nxtkim-1/hand-dynamometer/README.md

# hand-dynamometer

A low-cost, 3D-printed grip strength dynamometer built around a load cell, an HX711 amplifier, and an Arduino, together with a Python application that administers a standardized grip test, analyzes the full force-time curve, and compares the result with published normative data.

> **Educational project.** This device is not a medical device and is not intended for diagnosis or clinical decision-making.

<p align="center">
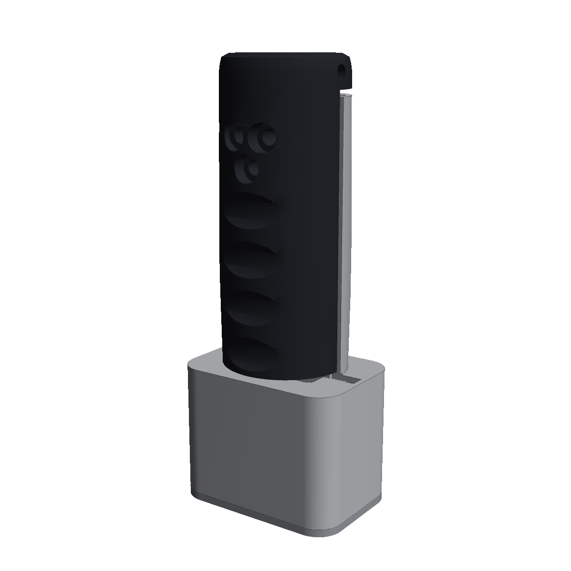
[picture p1: images/compact_v3_assembled.png]
3D-printed grip dynamometer (CAD render)
  
</p>

---

## Hardware

A handheld grip-strength instrument built around a **CZL601 100 kg load cell**. Its barrel-shaped handle splits into two halves; an **HX711** amplifier and **Arduino Nano** read the load cell and send the data to a laptop. Calibration uses known masses through the same load path as a real squeeze.

**Current version: v3** — The split-grip barrel handle has a **flat chamfered top** and sits on a **closed 57 × 82 mm electronics box** (~204 mm tall) for the Nano, HX711 and coiled, uncut cable. All four v3 parts are **native, from-scratch parametric models** in Onshape — **[Hand Dynamometer v3](https://cad.onshape.com/documents/14d87426a9f5f0f89acb0ff1/w/cbee608c747a369f00bd9d19/e/3240b9b82e6414542f1a770b)** (private). The palm half, finger half, bay cover and base test were rebuilt feature by feature (sketches, revolves, extrudes and bolt pattern) from `cad/dynamometer_cad.py` and the v3 mesh measurements. The Jamar-style two-handle concept, a possible **v4 prototype** (`docs/13_jamar_concept.md`, `cad/jamar_concept.py`), is modeled in the same document as a separate part studio with a frame, palm bar, finger part and cover. The renders below show v2 (dome top, round flared base); v3 renders are still pending. Superseded v2 CAD files remain in `cad/archive/superseded_2026-10-16/`.

**CAD status:** All five Onshape part studios regenerate cleanly as native parametric models; known open items are tracked in [docs/14_cad_open_items.md](docs/14_cad_open_items.md).

The grip splits lengthwise. The **grey palm half** bolts to the bottom of the load cell, and the **black finger half** bolts to its top. A 3 mm seam keeps the halves apart, so every squeeze has to pass through the load cell.

A full explanation of the features and design process is in **[`docs/12_design.md`](docs/12_design.md)**.

## Screenshots

Onshape proof captures for the v3 parts and Jamar concept:

- [Palm half](docs/proofs/palm-half.png)
- [Finger half](docs/proofs/finger.png)
- [Bay cover](docs/proofs/cover.png)
- [Base test](docs/proofs/base.png)
- [Jamar v4 concept](docs/proofs/jamar.png)

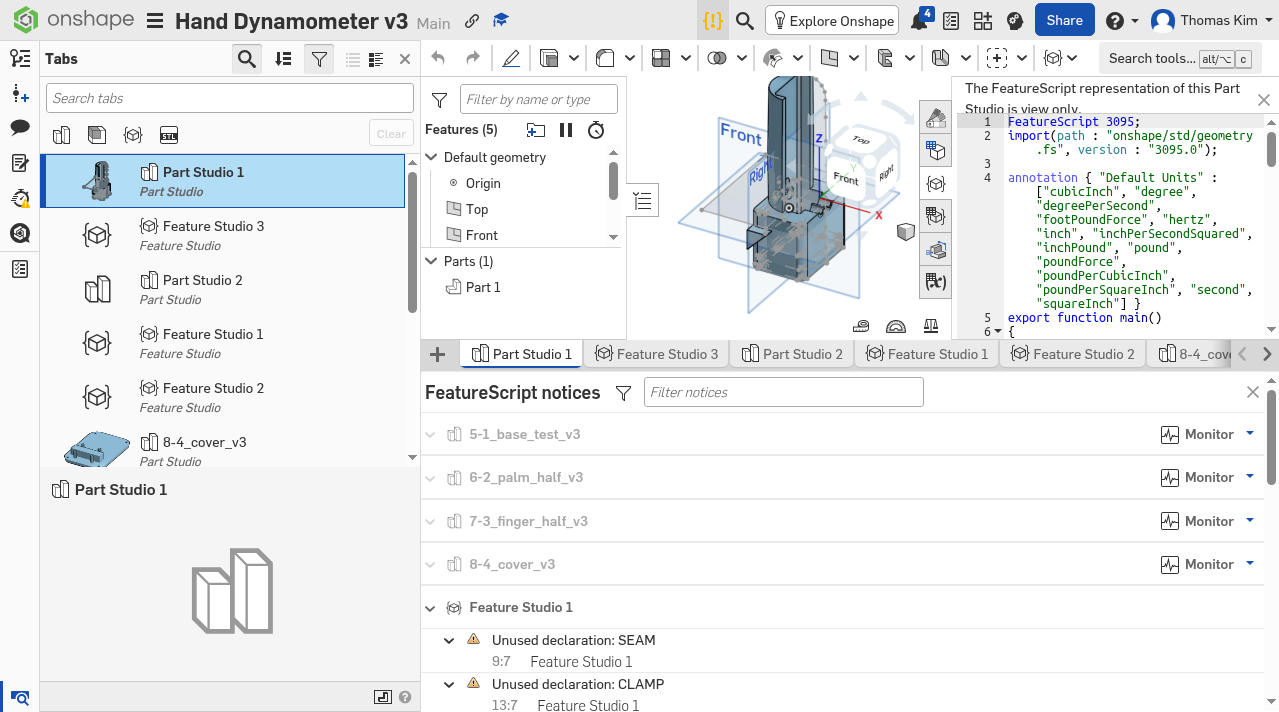
[picture p2: docs/proofs/palm-half.png]
Onshape proof screenshot: v3 palm half


---

## Motivation

Grip strength is one of the simplest and most widely used indicators of overall muscle function. It is associated with mobility, recovery after surgery, and all-cause mortality, and it is a core criterion in current definitions of sarcopenia. Clinical dynamometers such as the Jamar, however, report only a single peak value and cost several hundred dollars.

This project was undertaken to examine whether an inexpensive device could reproduce that peak measurement while also recording the entire force-time curve. Access to the full curve allows metrics that a mechanical dial cannot provide, including the rate at which force develops and the extent to which it declines during sustained effort.

Grip strength is a validated clinical measure and a diagnostic criterion for sarcopenia (EWGSOP2: < 27 kg for men, < 16 kg for women). In the PURE study of about 140,000 people, it predicted mortality better than systolic blood pressure. This device logs the full force–time curve (80 samples per second recommended; see "Run with the Arduino").

---

## Features

- **Web app (GripCheck).** `python webapp.py` opens the test in the browser: a participant form (age, sex, dominant hand, and optional ID, height, weight and injury history), posture instructions, a 3-2-1 countdown, a live force graph, immediate feedback on each trial with the option to repeat it, timed rest periods, and a final report that can be saved as a PDF with the same layout.
- **Standardized protocol.** The application guides the user through three maximal trials per hand, alternating hands to allow recovery, followed by a 30-second sustained-effort fatigue test. Posture instructions and verbal encouragement are fixed in the code so that every trial is administered identically, in keeping with the American Society of Hand Therapists (ASHT) recommendations.
- **Live visualization.** Force is plotted in real time on a scrolling five-second window while each trial is recorded.
- **Five force-time metrics.** Peak force, time to peak force, rate of force development (RFD), fatigue index, and bilateral asymmetry are computed for every session.
- **Normative comparison.** The best grip is compared with age- and sex-specific values from Dodds et al. (2014) and reported as a percentile band, a Z-score, an estimated percentile, and a T-score. The EWGSOP2 and AWGS 2019 cut-offs for low grip strength are applied to users aged 65 and over.
- **Complete data retention.** Every session is saved under a unique timestamp as a raw force-time file, a per-trial summary file, and a centile plot, so that new metrics can later be computed from existing recordings without repeating the test.
- **Hardware-independent development.** A single setting (`USE_FAKE`) switches between the Arduino and a realistic simulated signal, which allows the entire application to be run and tested without the device.
- **Live HTML report.** A browser page opens after the first trial and refreshes as each recording finishes, showing peak force, trial-to-trial coefficient of variation, force-time curves, and the normative comparison.
- **Signal filtering.** Metrics are computed on curves smoothed with a zero-phase, 4th-order Butterworth low-pass filter (10 Hz), while the raw signal is saved unchanged. In a Monte Carlo comparison of 300 simulated trials, this filter reduced the spread of RFD error with little bias, whereas a 5-point moving average introduced a consistent overestimate.
- **Session history.** `history.py` uses pandas to combine every saved session into a dashboard of best peak force, coefficient of variation, and fatigue index over time.
- **Automatic trial-quality check.** Each maximal trial is classified as good, false start, slip, or submaximal effort from five shape features, and the operator is warned immediately so that the trial can be repeated. A Random Forest trained on 2,000 synthetic curves reached 99% test accuracy, compared with 92% for hand-tuned rules. Because the training data are simulated, this result demonstrates the pipeline rather than accuracy on real users.
- **Hardware safeguards.** The app accepts both the simulator's two-column format and the firmware's four-column format, measures the real sample rate of every recording, adapts the filter to it, reports RFD as n/a when sampling is too slow to estimate it, and stops with a clear message if the firmware has not been calibrated.
- **Automated tests.** A pytest suite (34 tests) checks the metrics against curves with known answers, verifies that filtering does not shift the signal in time, and runs the full protocol end to end, in the terminal app and in the web app, with simulated data and with a simulated Arduino that speaks the real firmware format.

### Example output
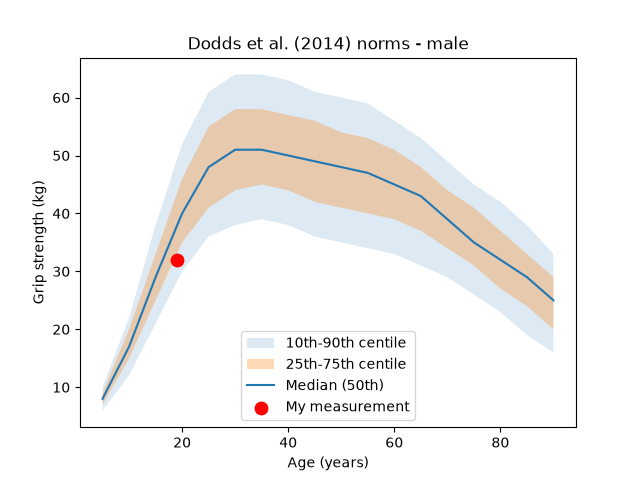
[picture p3: images/centile_plot.png]
Grip strength plotted on Dodds et al. (2014) centile curves


---

## How to run

The top-level Python app runs a standardized grip test on the device, or on fake data while the hardware is being built.

### Requirements
Python 3.9 or later.

```bash
pip install -r requirements.txt
```

### Run the web app (recommended)
```bash
python webapp.py
```
A browser tab opens at **http://localhost:8000**. Follow the instructions on screen; press **Download PDF** on the final report to save it. The newest report is always at http://localhost:8000/report. The app only accepts connections from this computer. (Port 8000 is used because macOS reserves 5000 for AirPlay.)

### Public online demo
The repository includes `render.yaml`, so the web app can be published on [Render](https://render.com) for free:
1. Sign in to Render with GitHub and choose **New → Blueprint**.
2. Select this repository. Render reads `render.yaml`, installs `requirements.txt`, and starts the app with gunicorn.
3. After a few minutes the demo is live at `https://<service-name>.onrender.com`.

The online demo runs with `GRIPCHECK_DEMO=1`: every squeeze is simulated (no device can be connected over the internet), each visitor's test is kept separate, and each report is reachable only through its own private link. On the free plan the server sleeps after about 15 minutes without visitors, so the first page load afterwards can take up to a minute.

### Run in the terminal
```bash
python grip_test.py
```
Enter age, sex, and dominant hand when prompted, then press Enter before each trial. Results are printed to the terminal and saved to the `sessions/` folder.

### Run with the Arduino

No code needs editing. Plug the dynamometer in by USB and close the Arduino IDE's Serial Monitor (only one program can use the port).

**Windows, double-click:** `check_device.bat` runs a one-minute check (hands off, squeeze, let go) and prints PASS/WARN/FAIL with fixes. `start_gripcheck.bat` then opens GripCheck with the device. The first run installs the Python packages into `.venv` (Python 3.12 from python.org must be installed, with "Add python.exe to PATH" ticked).

**From a terminal (any OS):**
```bash
python software/check_device.py      # health check
python webapp.py --device            # web app, port found automatically
python grip_test.py --device         # terminal version
python webapp.py --device --port COM7   # only if several serial devices are plugged in
```

**In the browser (Chrome or Edge):** run `python webapp.py`, or open a deployed GripCheck site, and press **Connect device** on the first screen. The browser reads the device through Web Serial and the server analyses each trial exactly as in the other routes. On a deployed site, nothing has to be installed on the visitor's computer.

**Firmware:** upload `firmware/grip_firmware_tillaart/grip_firmware_tillaart.ino` (Rob Tillaart's HX711 library) or `firmware/grip_firmware/grip_firmware.ino` (Bogdan Necula's). Both print `t_ms,raw,net,force_kg` at 115200 baud and re-zero on `T`.

**Calibration status (2026-11-12): estimated.** `COUNTS_PER_KG = 42952` comes from the load-cell datasheet (about ±10 %), not from known masses. The app and every report say so in a banner. After the known-mass calibration (`docs/04_calibration.md`), paste the fitted value into the firmware and set `CALIBRATION = "measured"` in `grip_test.py` (or `GRIPCHECK_CALIBRATION=measured`); the banner then disappears.

**Sample rate:** the HX711 runs at 10 samples/s until its RATE pin is tied high (80 samples/s). At 10 Hz everything works except rate of force development, which is reported as n/a.

### Run the tests
```bash
python -m pytest
```

### Other scripts
| Command | Purpose |
|---|---|
| `python fake_data.py` | Plots one simulated maximal trial and one simulated fatigue trial |
| `python metrics.py` | Computes all metrics on simulated curves as a quick self-check |
| `python grip_compare.py` | Prints normative reports for four example cases |
| `python filters.py` | Compares raw, moving-average and Butterworth RFD over 300 simulated trials |
| `python history.py` | Builds a dashboard of all saved sessions |
| `python quality.py` | Shows the rule-based quality check on one curve of each fault type |
| `python train_quality.py` | Trains and evaluates the trial-quality classifier |

## Project structure

```
hand-dynamometer/
├── grip_test.py        # Main application: protocol, live plot, saving, summary
├── metrics.py          # Peak force, time to peak, RFD, fatigue index, asymmetry
├── grip_compare.py     # Comparison with Dodds et al. (2014) norms and clinical cut-offs
├── fake_data.py        # Simulated force-time curves (good and faulty trials) for hardware-free testing
├── webapp.py           # Browser version of the test (Flask): same protocol, metrics and report
├── render.yaml         # Settings for the public online demo on Render
├── web/                # Web app pages: index.html, style.css, app.js (live graph, countdown)
├── report.py           # HTML session report (live in the terminal app, final in both; prints to PDF)
├── filters.py          # Moving-average and Butterworth filters, sample-rate estimate
├── history.py          # pandas dashboard of all sessions
├── quality.py          # Rule-based and ML trial-quality check
├── train_quality.py    # Trains the Random Forest classifier
├── models/             # Saved quality model
├── tests/              # pytest suite
├── requirements.txt
├── cad/
│   ├── dynamometer_cad.py   # The whole design, parametric; regenerates every part and checks it
│   ├── render_final.py      # The renders in images/
│   ├── draw_final.py        # The dimensioned drawing
│   ├── output/              # STL + STEP per part, assembly.step
│   ├── output/print_ready/  # STLs ready for Bambu Studio (do not rotate them)
│   └── archive/             # Earlier design iterations
├── firmware/
│   └── grip_firmware/       # Arduino sketch
├── software/           # logger.py, calibrate.py, analyze_hold.py: serial logging and calibration
├── data/               # dodds2014_norms.csv, example calibration points
├── docs/               # Design notes, incl. 12_design.md and 13_jamar_concept.md (v4 concept)
├── images/             # Renders, drawings, and photos
├── practice/           # Earlier development versions, kept for reference
└── sessions/           # Saved test sessions (excluded from version control)
```

### Data format
The simulator sends one line per sample at 50 samples per second; the firmware sends four columns:
```
timestamp_ms,force_kg               (simulator)
timestamp_ms,raw,net,force_kg       (firmware)
```
The app reads the first column as time and the last column as force, so both formats work without changes. Lines that are not data, such as `# tared`, are skipped.

---

## Metric definitions

| Metric | Definition |
|---|---|
| **Onset** | The first sample at which force exceeds 5% of the trial's peak. A relative threshold is used so that sensor noise is not mistaken for the start of a squeeze. |
| **Peak force (kg)** | The highest force recorded during the trial. The best of three trials per hand is reported, consistent with the method used to construct the normative data. |
| **Time to peak (ms)** | The time from onset to peak force. |
| **Rate of force development (N/s)** | The slope of a least-squares line fitted to force (converted to newtons, 1 kg = 9.81 N) over the first 200 ms after onset. Fitting a line to all points in the window, rather than using only the first and last points, reduces the influence of individual noisy samples. |
| **Fatigue index (%)** | (Peak force − mean force during the final second of the 30 s effort) ÷ peak force × 100. The final second is averaged rather than taken as a single point to reduce the effect of noise. |
| **Bilateral asymmetry** | The ratio of left-hand to right-hand peak force, together with the percentage by which the weaker hand is weaker. The commonly cited "10% rule" for the dominant hand is not applied, because the literature does not support it consistently; the values are reported without a verdict. |

---

## Normative data

Normative grip strength values are transcribed from Table 2 of:

Dodds RM, Syddall HE, Cooper R, et al. (2014). Grip Strength across the Life Course: Normative Data from Twelve British Studies. *PLoS ONE* 9(12): e113637. https://doi.org/10.1371/journal.pone.0113637 (CC BY 4.0)

The measurement is matched to the row with the closest age and the same sex. The Z-score uses that row's mean and standard deviation, and the T-score uses the young-adult peak (age 32) from the same study.

### Why 27 kg and 16 kg?
The EWGSOP2 cut-offs for low grip strength (men < 27 kg, women < 16 kg) correspond to a T-score of −2.5 relative to the young-adult peak reported by Dodds et al. (2014):
- Men: 51.9 − 2.5 × 9.9 = 27.15 kg
- Women: 31.4 − 2.5 × 6.1 = 16.15 kg

Both EWGSOP2 (Cruz-Jentoft et al., 2019) and AWGS 2019 (Chen et al., 2020) define these cut-offs for older adults, so they are reported only for users aged 65 and over.

---

## Validation (in progress)

The software has been developed and tested using simulated signals. Validation of the physical device is planned in two stages:

1. **Calibration.** Known masses will be applied across the measurement range (at least five points), and linearity will be reported as maximum deviation as a percentage of full scale rather than R², since R² is close to 1 for almost any load cell and therefore says little about accuracy.
2. **Agreement with a clinical device.** Paired measurements will be taken with this device and a Jamar hydraulic dynamometer under the same ASHT protocol, and agreement will be assessed with Bland-Altman analysis (bias and 95% limits of agreement). Correlation alone is not used, because two devices can be perfectly correlated while still disagreeing by a constant amount.

Results will be added to this section once the hardware is complete.

---

## Limitations

- All results shown in this repository were produced with **simulated data**. They demonstrate that the analysis pipeline works, not that the device is accurate.
- The normative data come from British cohorts and may not represent other populations.
- The comparison uses the nearest age band rather than interpolating between bands.
- The trial-quality model was trained only on simulated curves sampled at 50 Hz; it has not yet been tested on real fault trials.
- The estimated percentile assumes that grip strength is normally distributed within each age band, which is an approximation.
- Any future validation will involve a small number of participants (the authors), so it will indicate feasibility rather than establish clinical accuracy.

---

## Authors

- **Thomas Kim** — hardware design, mechanical assembly, and Arduino firmware
- **Samuel Koo** — Python application, signal analysis, and normative comparison

## License

Software is released under the MIT License. Hardware design files, documentation, and images are released under CC BY 4.0. See [LICENSE](LICENSE) for details.
