nxtkim-1/hand-dynamometer/docs/14_cad_open_items.md

# CAD open items

These details are tracked rather than treated as resolved. Check them during assembly and physical verification.

- The bay-cover pedestal overlaps the palm's bay slab by about 2 mm in the models. Both parts follow their own meshes; check the fit at assembly.
- The finger-half model follows the v2 parametric length, while the v3 finger mesh is about 19 mm shorter. Groove and hook placement on the physical v3 finger is unverified.
- The base-test model approximates the pocket-to-shelf ramp with the palm's boss/ledge/gusset profile.
