nxtkim-1/hand-dynamometer/docs/proofs/base.png

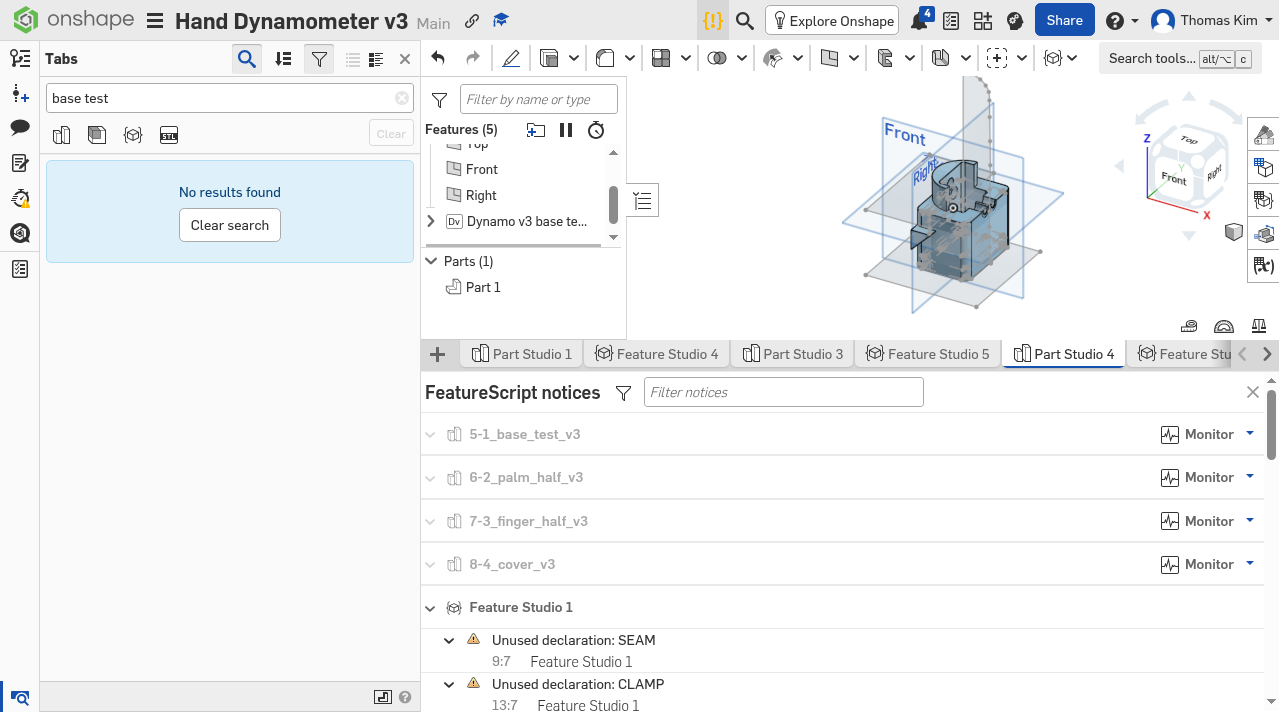
docs/proofs/base.png
