nxtkim-1/hand-dynamometer/docs/proofs/cover.png

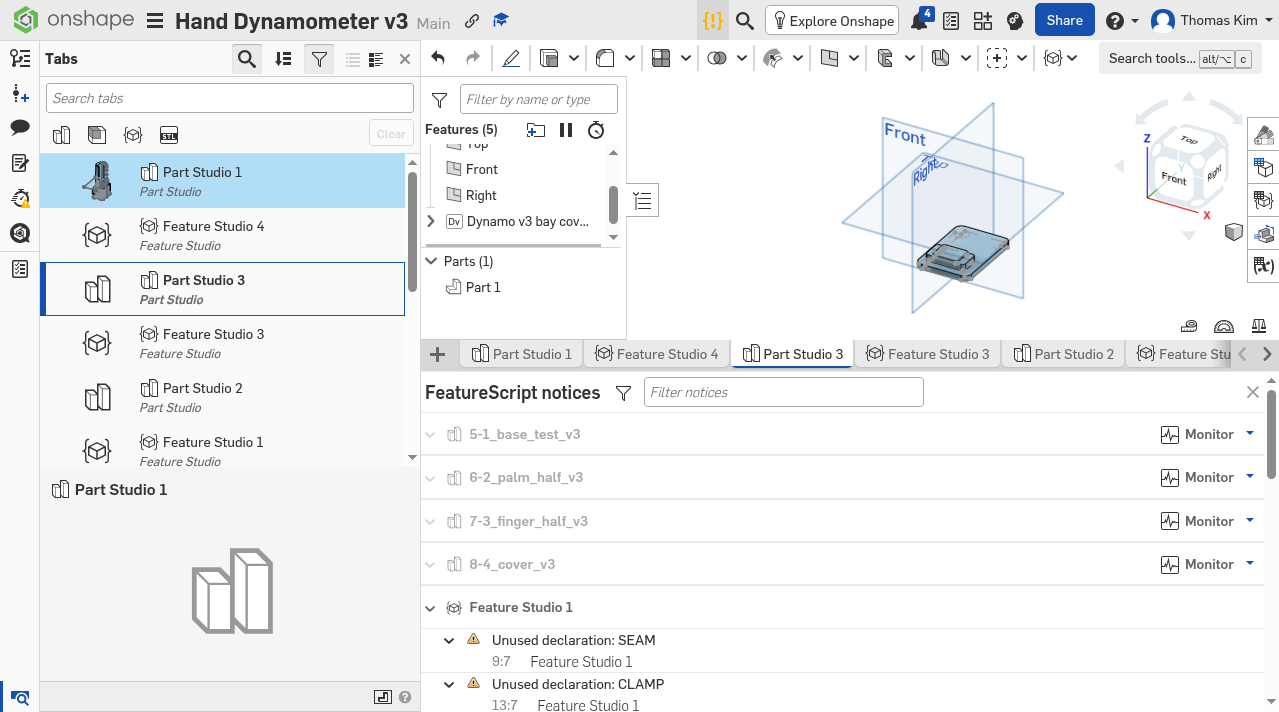
docs/proofs/cover.png
