nxtkim-1/hand-dynamometer/docs/proofs/finger.png

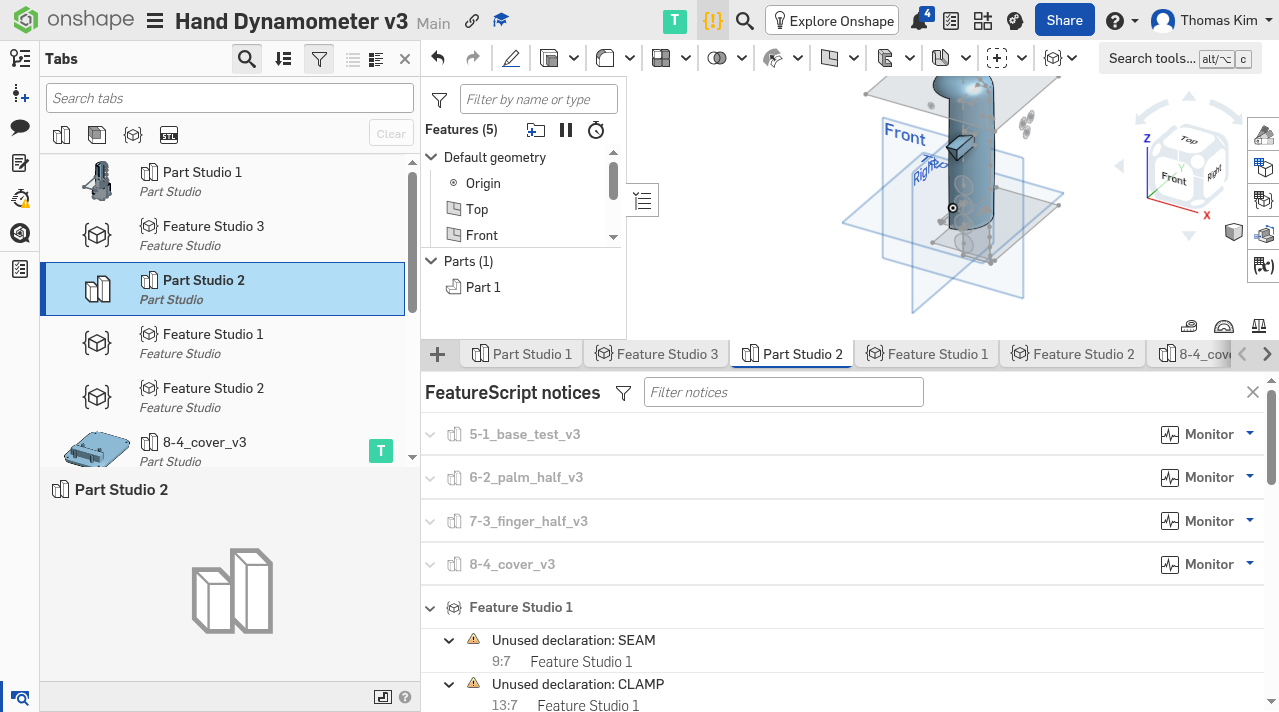
docs/proofs/finger.png
