nxtkim-1/hand-dynamometer/images/compact_v3_cable_bay.png

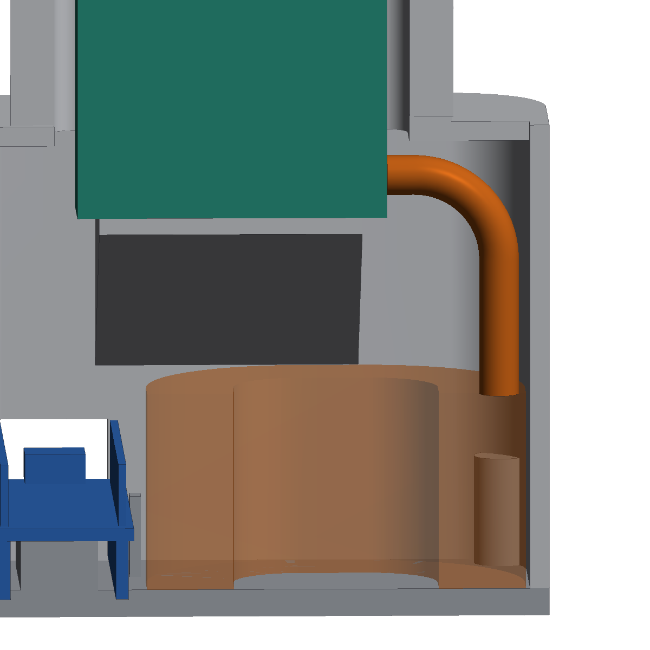
images/compact_v3_cable_bay.png
