nxtkim-1/hand-dynamometer/images/compact_v3_inside.png

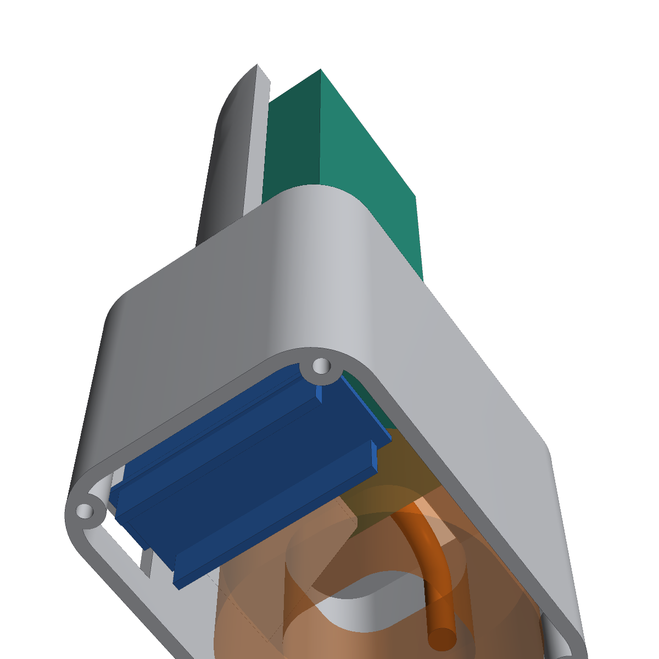
images/compact_v3_inside.png
