nxtkim-1/hand-dynamometer/images/dish_draft_section.png

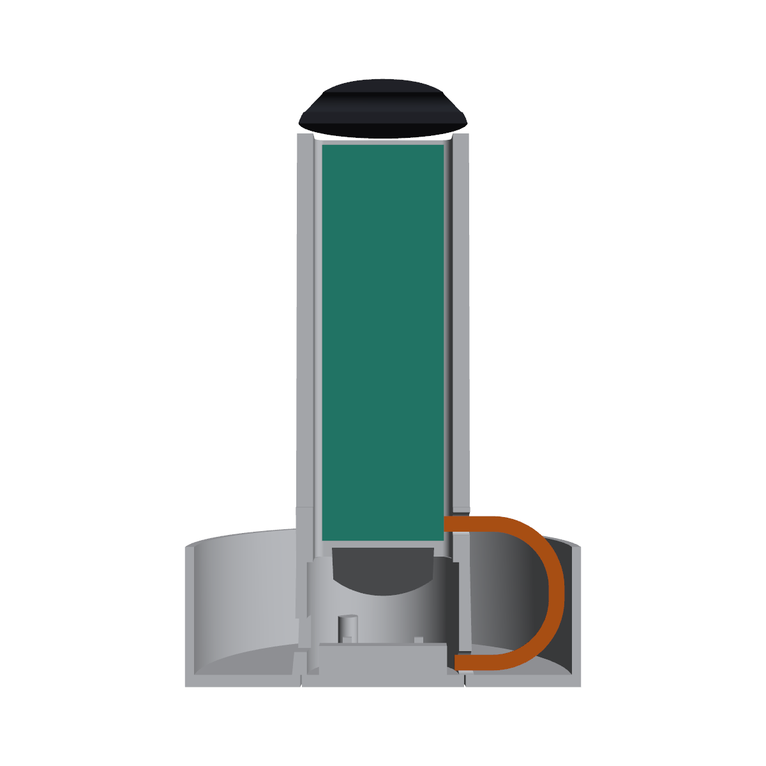
images/dish_draft_section.png
