nxtkim-1/hand-dynamometer/images/filter_comparison.png

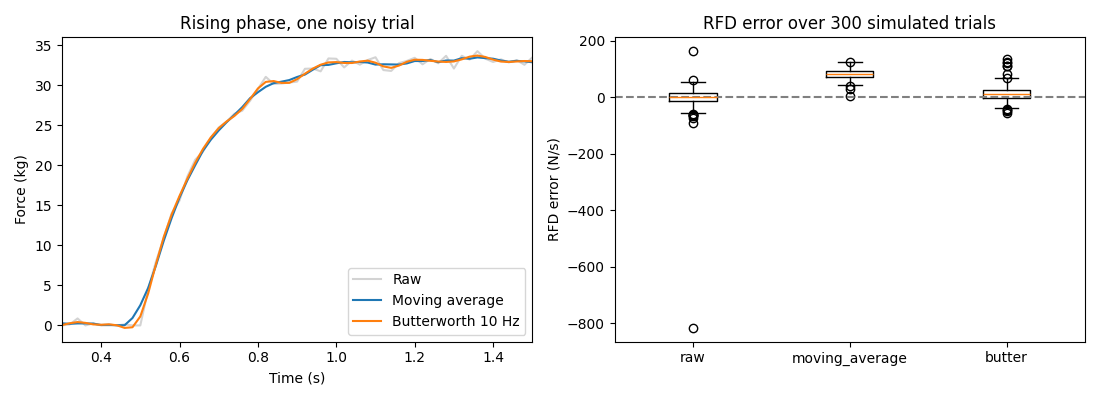
images/filter_comparison.png
