nxtkim-1/hand-dynamometer/images/final_drawing.png

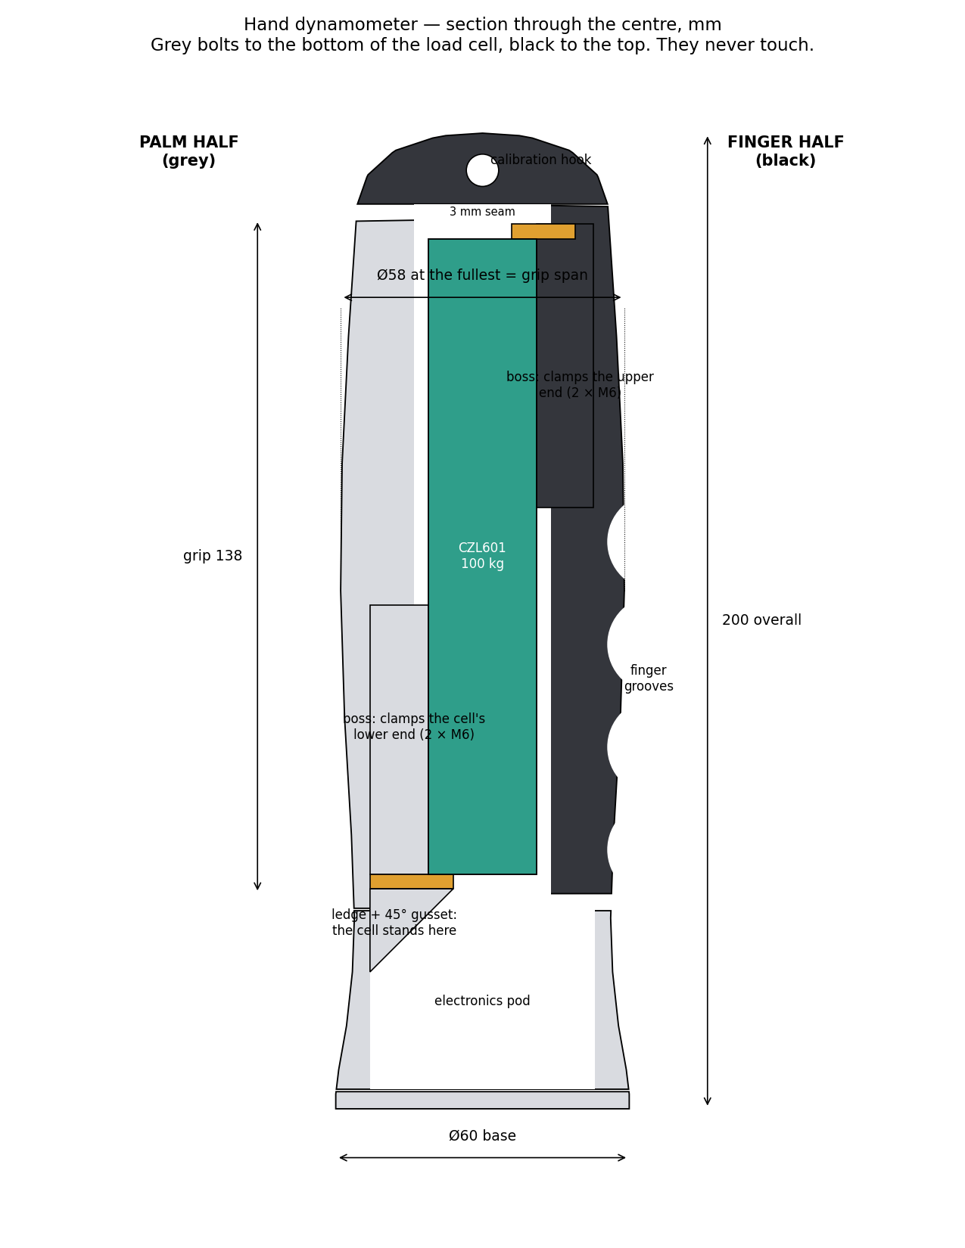
images/final_drawing.png
