nxtkim-1/hand-dynamometer/images/jamar_concept_section.png

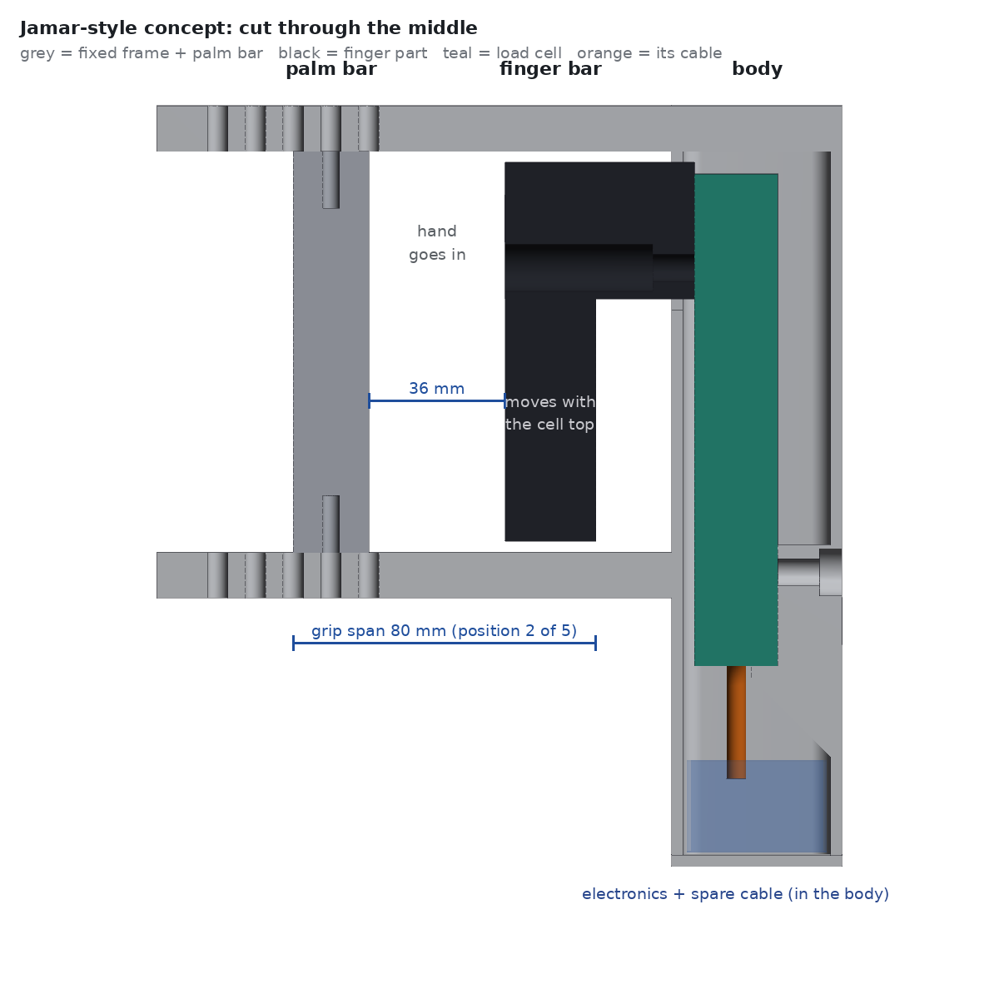
images/jamar_concept_section.png
