nxtkim-1/hand-dynamometer/images/jamar_concept_view.png

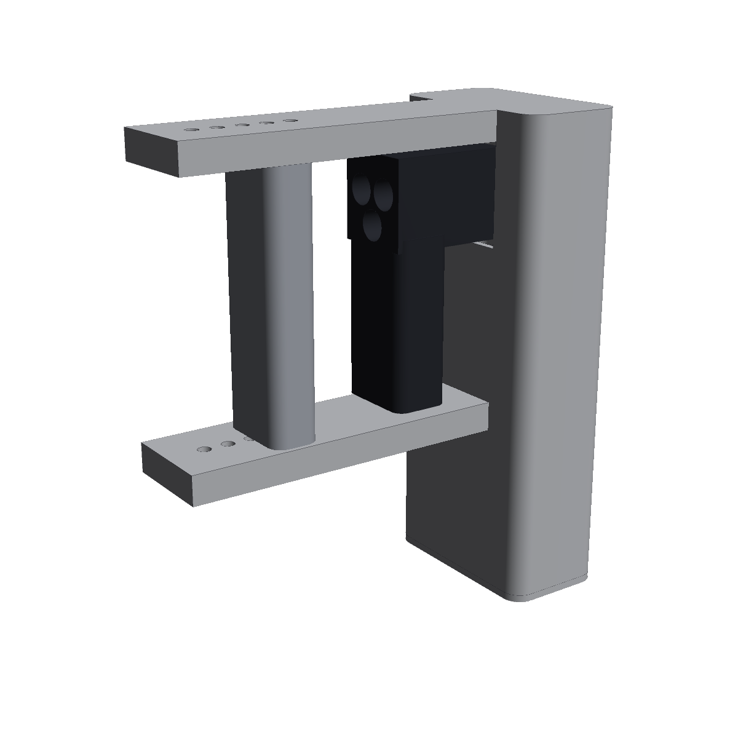
images/jamar_concept_view.png
