nxtkim-1/hand-dynamometer/images/options_compact_vs_dish.png

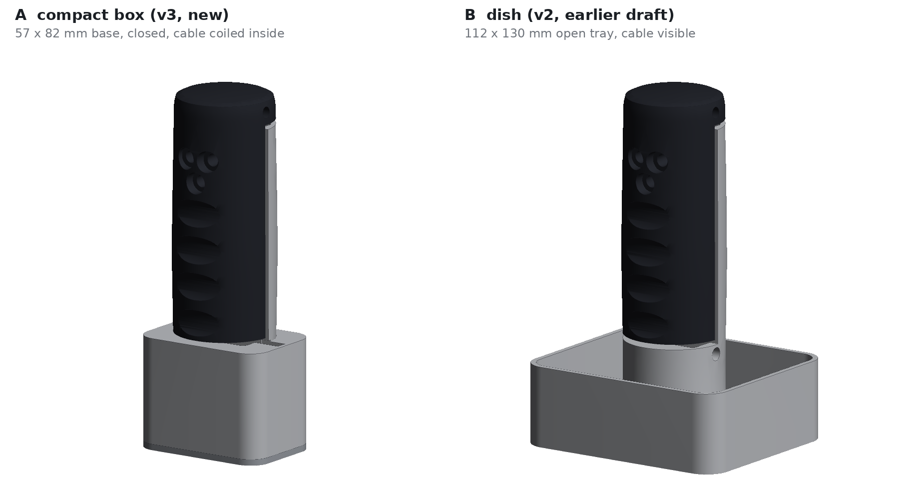
images/options_compact_vs_dish.png
