nxtkim-1/hand-dynamometer/images/photos/2026-10-12_cell_side.jpg

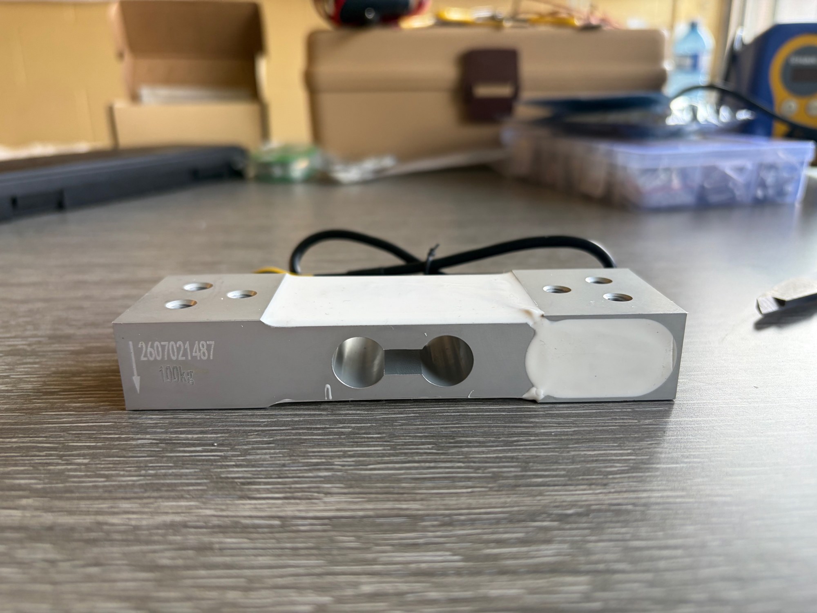
images/photos/2026-10-12_cell_side.jpg
