nxtkim-1/hand-dynamometer/images/photos/2026-10-12_cell_top.jpg

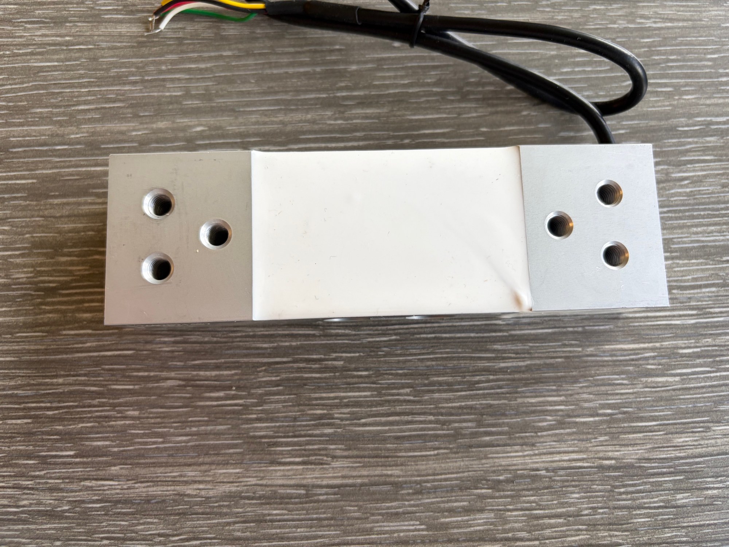
images/photos/2026-10-12_cell_top.jpg
