nxtkim-1/hand-dynamometer/images/photos/reference_hx711.png

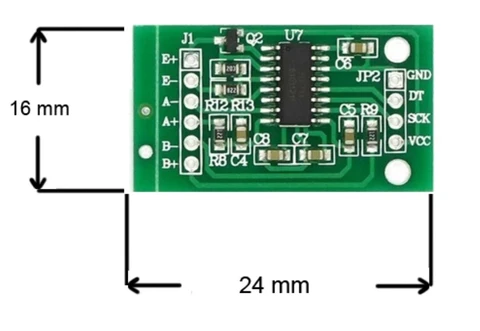
images/photos/reference_hx711.png
