nxtkim-1/hand-dynamometer/images/photos/reference_nano_3d.png

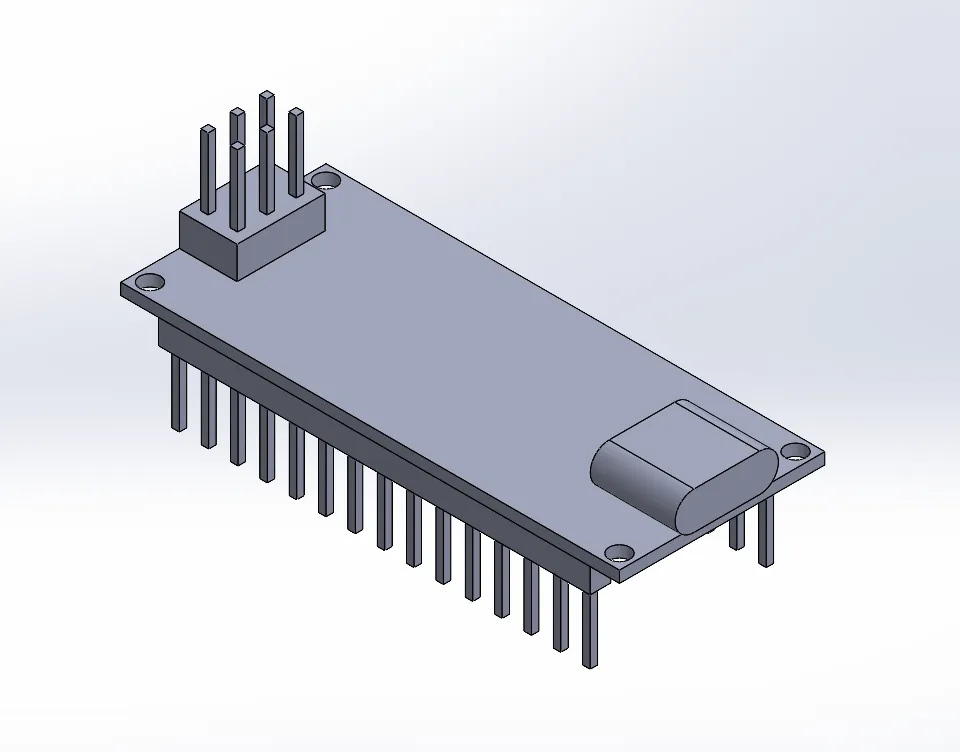
images/photos/reference_nano_3d.png
