nxtkim-1/hand-dynamometer/images/photos/reference_nano_drawing.png

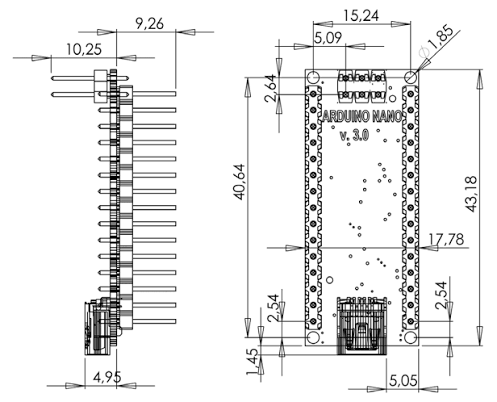
images/photos/reference_nano_drawing.png
