nxtkim-1/hand-dynamometer/images/pod_layout.png

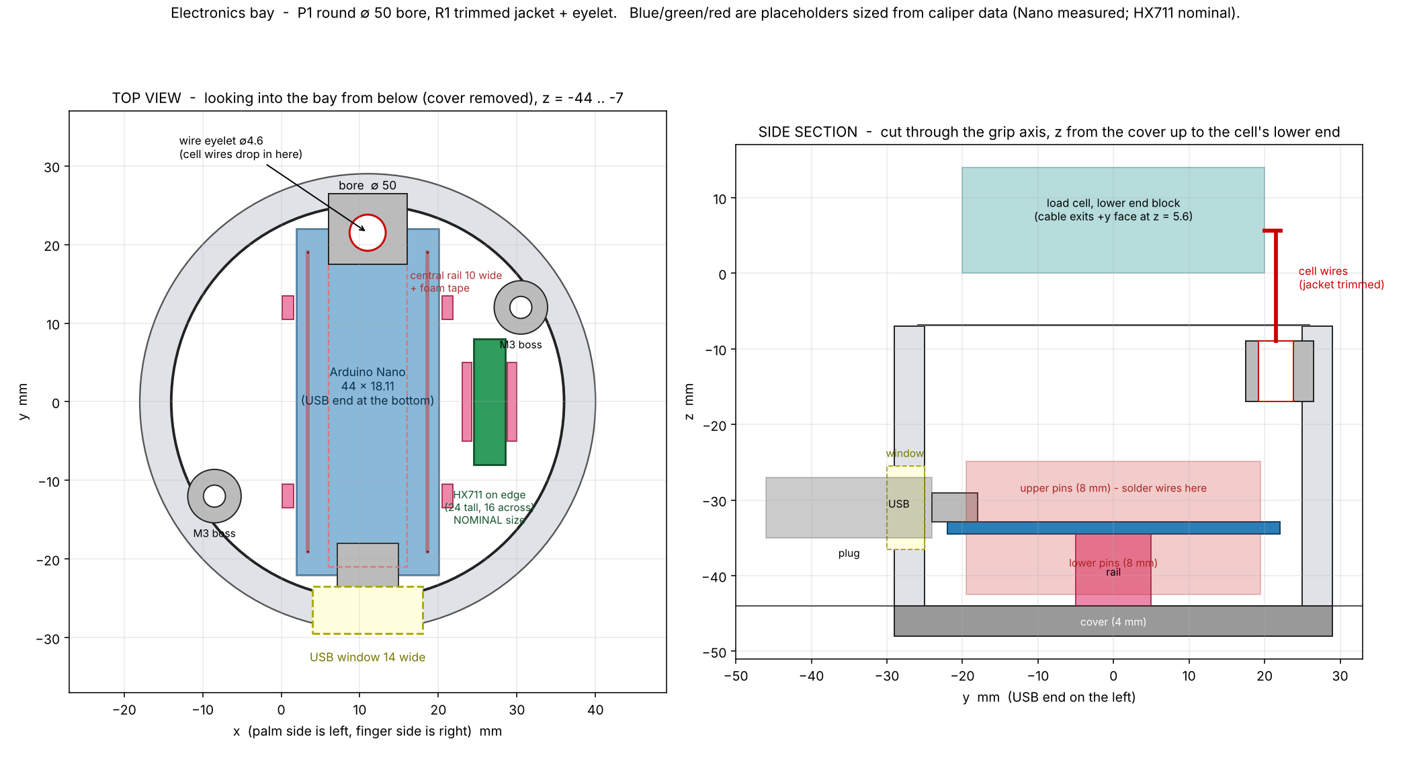
images/pod_layout.png
