nxtkim-1/hand-dynamometer/images/quality_model.png

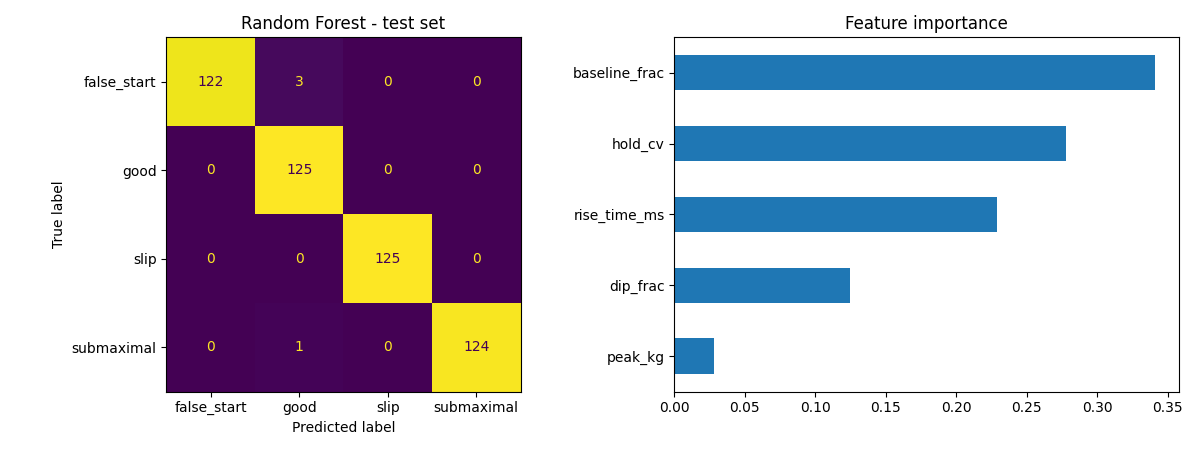
images/quality_model.png
