nxtkim-1/hand-dynamometer/cad/output/concept_jamar/cover_CONCEPT.step

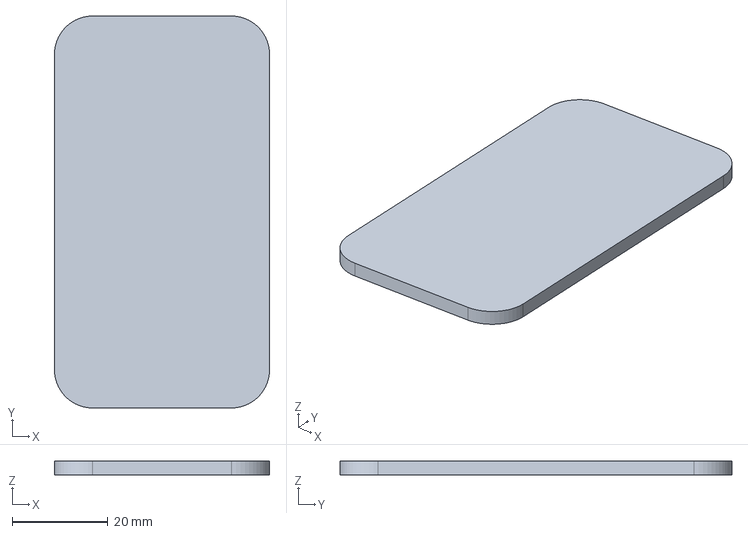
[picture p23: CAD file, 2026-10-20]
cad/output/concept_jamar/cover_CONCEPT.step
45.0 x 82.0 x 3.00 mm
