nxtkim-1/hand-dynamometer/cad/output/print_ready/3_finger_half_v3.stl

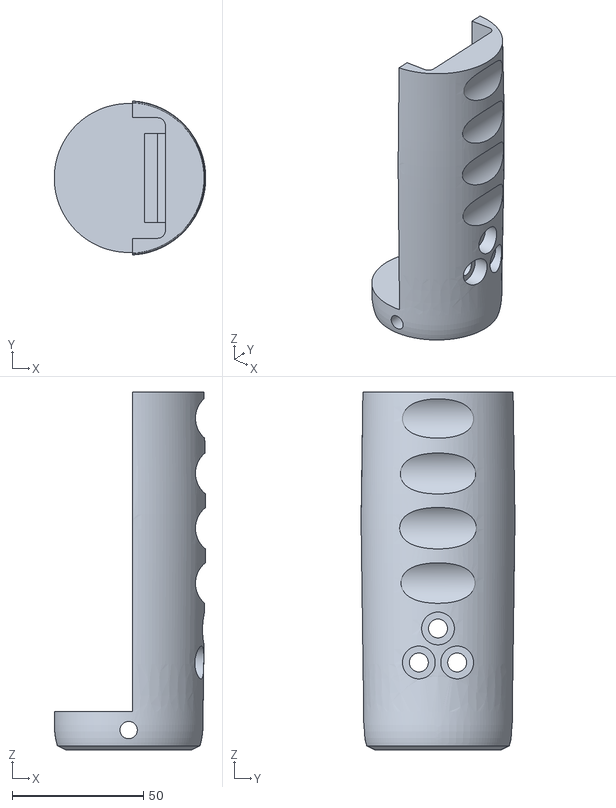
[picture p24: CAD file, 2026-10-20]
cad/output/print_ready/3_finger_half_v3.stl
57.8 x 58.7 x 136.6
