nxtkim-1/hand-dynamometer/cad/output/v3/coil_zone_v3.stl

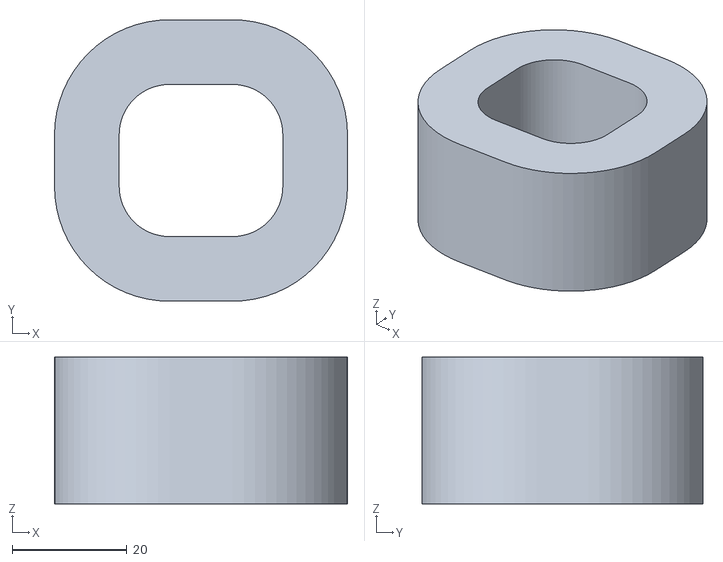
[picture p25: CAD file, 2026-10-20]
cad/output/v3/coil_zone_v3.stl
51.0 x 49.0 x 25.5
