nxtkim-1/hand-dynamometer/cad/output/concept_jamar/finger_part_CONCEPT.step

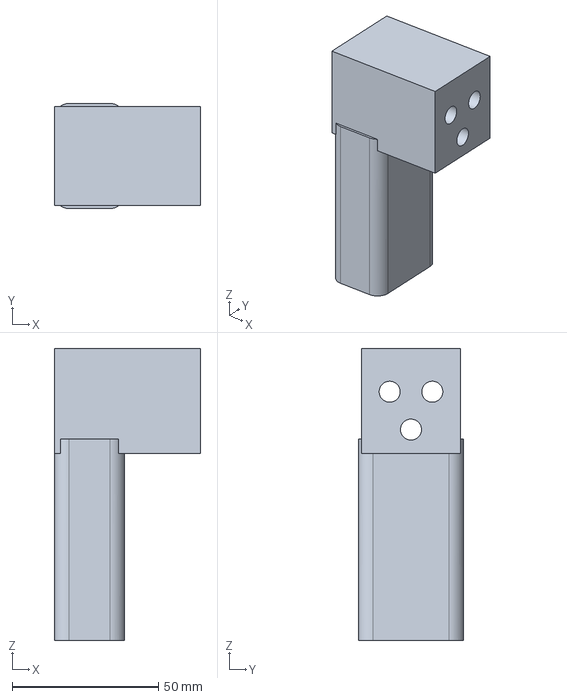
[picture p26: CAD file, 2026-10-20]
cad/output/concept_jamar/finger_part_CONCEPT.step
50.0 x 36.0 x 100.0 mm
