nxtkim-1/hand-dynamometer/cad/output/print_ready/fit_coupon_v2_print.stl

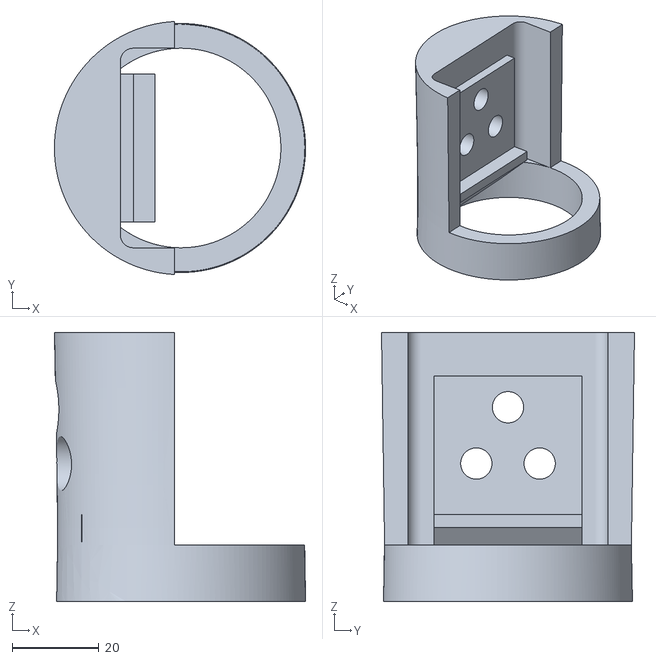
[picture p27: CAD file, 2026-10-20]
cad/output/print_ready/fit_coupon_v2_print.stl
57.9 x 58.3 x 62.0
