nxtkim-1/hand-dynamometer/cad/output/v3/base_test_v3.step

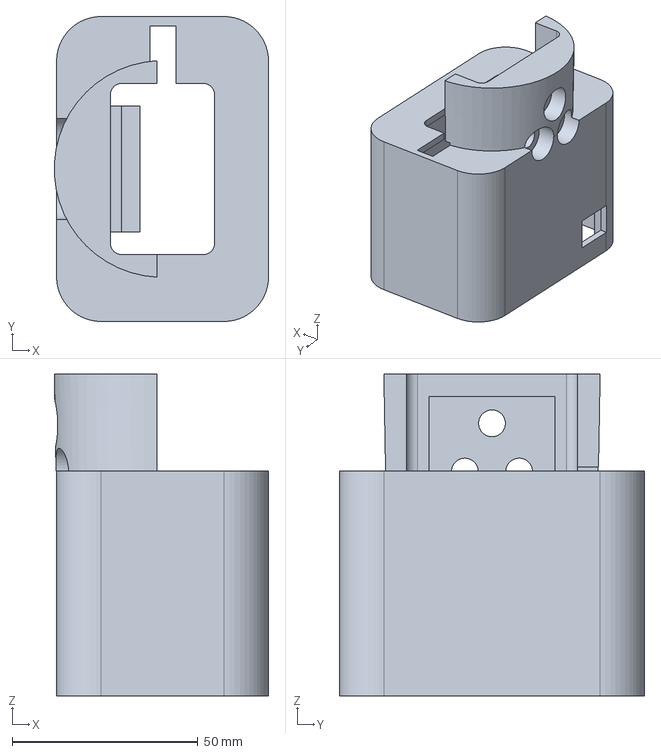
[picture p28: CAD file, 2026-10-20]
cad/output/v3/base_test_v3.step
57.6 x 82.0 x 86.5 mm
