nxtkim-1/hand-dynamometer/cad/output/concept_jamar/frame_CONCEPT.step

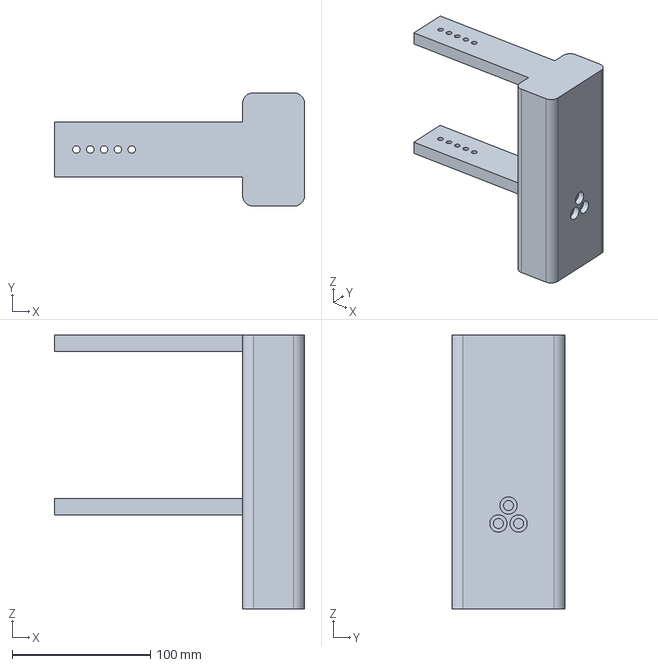
[picture p29: CAD file, 2026-10-20]
cad/output/concept_jamar/frame_CONCEPT.step
181.0 x 82.0 x 198.0 mm
