nxtkim-1/hand-dynamometer/cad/output/print_ready/4_cover_v3.stl

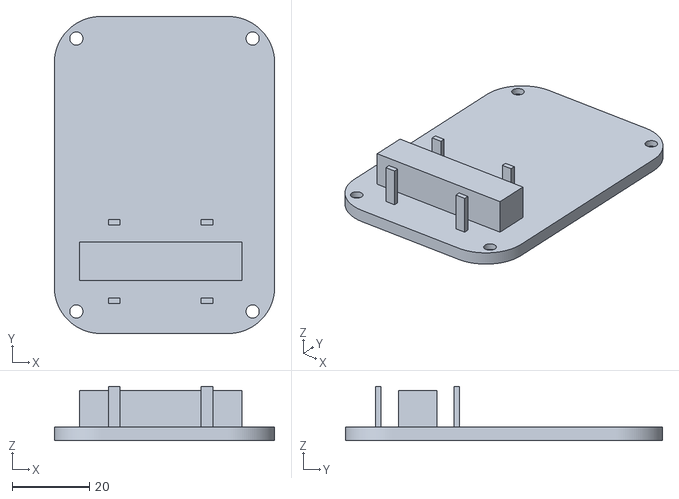
[picture p30: CAD file, 2026-10-20]
cad/output/print_ready/4_cover_v3.stl
57.0 x 82.0 x 14.0
