nxtkim-1/hand-dynamometer/cad/output/concept_jamar/palm_bar_CONCEPT.step

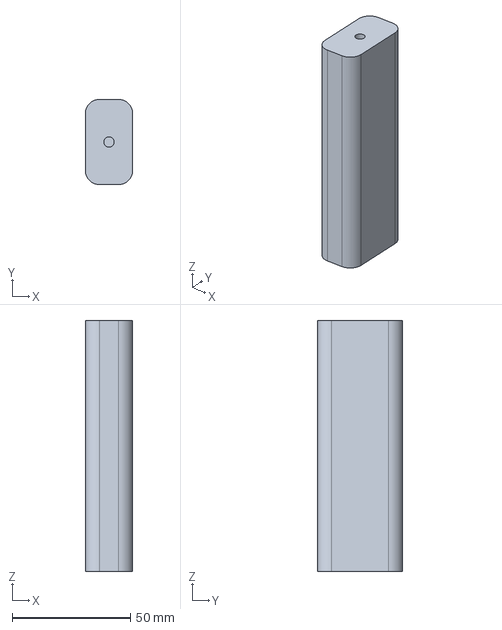
[picture p31: CAD file, 2026-10-20]
cad/output/concept_jamar/palm_bar_CONCEPT.step
20.0 x 36.0 x 106.0 mm
