nxtkim-1/hand-dynamometer/cad/output/print_ready/2_palm_half_v3.stl

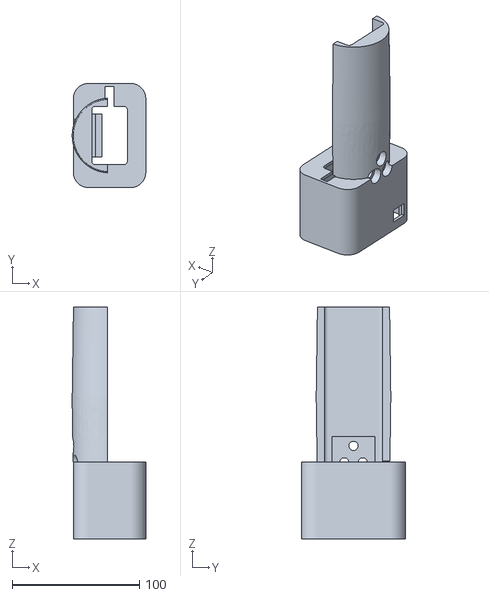
[picture p32: CAD file, 2026-10-20]
cad/output/print_ready/2_palm_half_v3.stl
57.9 x 82.0 x 182.5
