nxtkim-1/hand-dynamometer/cad/output/v3/cable_path_v3.stl

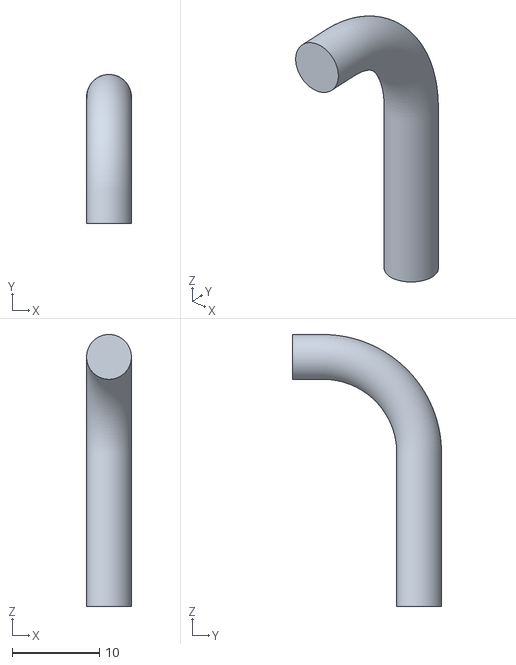
[picture p33: CAD file, 2026-10-20]
cad/output/v3/cable_path_v3.stl
5.13 x 17.1 x 31.1
