nxtkim-1/hand-dynamometer/cad/archive/v1_30mm_cell/output_v1/assembly.step

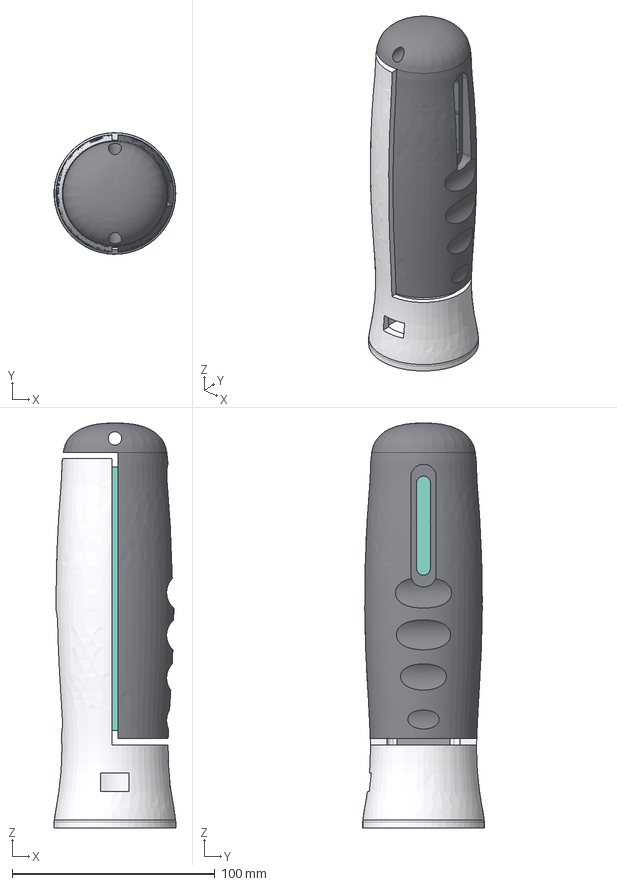
[picture p34: CAD file, 2026-10-20, an earlier design]
cad/archive/v1_30mm_cell/output_v1/assembly.step
59.9 x 60.0 x 199.6 mm
palm_half
finger_half
cover
load_cell
