nxtkim-1/hand-dynamometer/cad/archive/superseded_2026-10-16/round_pod_outputs/assembly.step

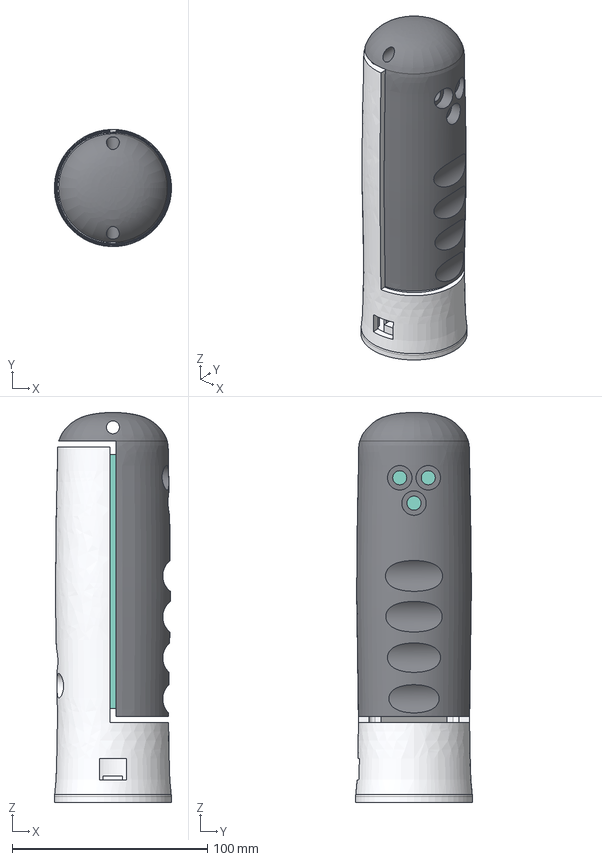
[picture p35: CAD file, 2026-10-20, an earlier design]
cad/archive/superseded_2026-10-16/round_pod_outputs/assembly.step
59.9 x 60.0 x 199.6 mm
palm_half
finger_half
cover
load_cell
