nxtkim-1/hand-dynamometer/(list of files, cad)

Other CAD files:
cad/output/v3/finger_compact_v3.step
cad/output/v3/cover_compact_v3.step
cad/output/print_ready/1_base_test_v3.stl
cad/output/v3/palm_compact_v3.step
cad/archive/superseded_2026-10-16/draft_compact/base_test_v3_DRAFT.step
cad/archive/superseded_2026-10-16/draft_compact/base_test_v3_DRAFT_do_not_print.stl
cad/archive/superseded_2026-10-16/draft_compact/cover_compact_v3_DRAFT.step
cad/archive/superseded_2026-10-16/draft_compact/finger_compact_v3_DRAFT.step
cad/archive/superseded_2026-10-16/draft_compact/finger_compact_v3_DRAFT_do_not_print.stl
cad/archive/superseded_2026-10-16/draft_compact/palm_compact_v3_DRAFT.step
cad/archive/superseded_2026-10-16/draft_dish/cable_path_model_v2.stl
cad/archive/superseded_2026-10-16/draft_dish/finger_dish_v2_DRAFT.step
cad/archive/superseded_2026-10-16/draft_dish/finger_dish_v2_DRAFT_do_not_print.stl
cad/archive/superseded_2026-10-16/draft_dish/palm_dish_v2_DRAFT.step
cad/archive/superseded_2026-10-16/draft_dish/palm_dish_v2_DRAFT_do_not_print.stl
cad/archive/superseded_2026-10-16/draft_dish/plug_v2_DRAFT.step
cad/archive/superseded_2026-10-16/draft_dish/plug_v2_DRAFT_do_not_print.stl
cad/archive/superseded_2026-10-16/draft_dish/v1_round_SUPERSEDED/cable_path_model.stl
cad/archive/superseded_2026-10-16/draft_dish/v1_round_SUPERSEDED/finger_dish_DRAFT.step
cad/archive/superseded_2026-10-16/draft_dish/v1_round_SUPERSEDED/finger_dish_DRAFT_do_not_print.stl
cad/archive/superseded_2026-10-16/draft_dish/v1_round_SUPERSEDED/palm_dish_DRAFT.step
cad/archive/superseded_2026-10-16/draft_dish/v1_round_SUPERSEDED/palm_dish_DRAFT_do_not_print.stl
cad/archive/superseded_2026-10-16/draft_dish/v1_round_SUPERSEDED/plug_DRAFT.step
cad/archive/superseded_2026-10-16/draft_dish/v1_round_SUPERSEDED/plug_DRAFT_do_not_print.stl
cad/archive/superseded_2026-10-16/print_after_G0/cover_print_after_G0.stl
cad/archive/superseded_2026-10-16/print_after_G0/finger_half_print_after_G0.stl
cad/archive/superseded_2026-10-16/print_after_G0/palm_half_print_after_G0.stl
cad/archive/superseded_2026-10-16/round_pod_outputs/calibration_cradle.step
cad/archive/superseded_2026-10-16/round_pod_outputs/calibration_cradle.stl
cad/archive/superseded_2026-10-16/round_pod_outputs/cover.step
cad/archive/superseded_2026-10-16/round_pod_outputs/cover.stl
cad/archive/superseded_2026-10-16/round_pod_outputs/finger_half.step
cad/archive/superseded_2026-10-16/round_pod_outputs/finger_half.stl
cad/archive/superseded_2026-10-16/round_pod_outputs/fit_coupon.step
cad/archive/superseded_2026-10-16/round_pod_outputs/fit_coupon.stl
cad/archive/superseded_2026-10-16/round_pod_outputs/load_cell_placeholder.stl
cad/archive/superseded_2026-10-16/round_pod_outputs/palm_half.step
cad/archive/superseded_2026-10-16/round_pod_outputs/palm_half.stl
cad/archive/superseded_2026-10-16/wip/calibration_cradle_WIP_do_not_print.stl
cad/archive/superseded_2026-10-16/wip/cover_WIP_do_not_print.stl
cad/archive/superseded_2026-10-16/wip/finger_half_WIP_do_not_print.stl
cad/archive/superseded_2026-10-16/wip/palm_half_WIP_do_not_print.stl
cad/archive/v1_30mm_cell/output_v1/calibration_cradle.step
cad/archive/v1_30mm_cell/output_v1/calibration_cradle.stl
cad/archive/v1_30mm_cell/output_v1/cover.step
cad/archive/v1_30mm_cell/output_v1/cover.stl
cad/archive/v1_30mm_cell/output_v1/finger_half.step
cad/archive/v1_30mm_cell/output_v1/finger_half.stl
cad/archive/v1_30mm_cell/output_v1/fit_coupon.step
cad/archive/v1_30mm_cell/output_v1/fit_coupon.stl
cad/archive/v1_30mm_cell/output_v1/load_cell_placeholder.stl
cad/archive/v1_30mm_cell/output_v1/palm_half.step
cad/archive/v1_30mm_cell/output_v1/palm_half.stl
cad/archive/v1_30mm_cell/output_v1/print_ready/calibration_cradle_print.stl
cad/archive/v1_30mm_cell/output_v1/print_ready/cover_print.stl
cad/archive/v1_30mm_cell/output_v1/print_ready/finger_half_print.stl
cad/archive/v1_30mm_cell/output_v1/print_ready/fit_coupon_print.stl
cad/archive/v1_30mm_cell/output_v1/print_ready/palm_half_print.stl
cad/archive/v1_30mm_cell/stale_print_ready/calibration_cradle_print.stl
cad/archive/v1_30mm_cell/stale_print_ready/cover_print.stl
cad/archive/v1_30mm_cell/stale_print_ready/finger_half_print.stl
cad/archive/v1_30mm_cell/stale_print_ready/fit_coupon_print.stl
cad/archive/v1_30mm_cell/stale_print_ready/palm_half_print.stl
