nxtkim-1/hand-dynamometer/images/drawing_wiring.png

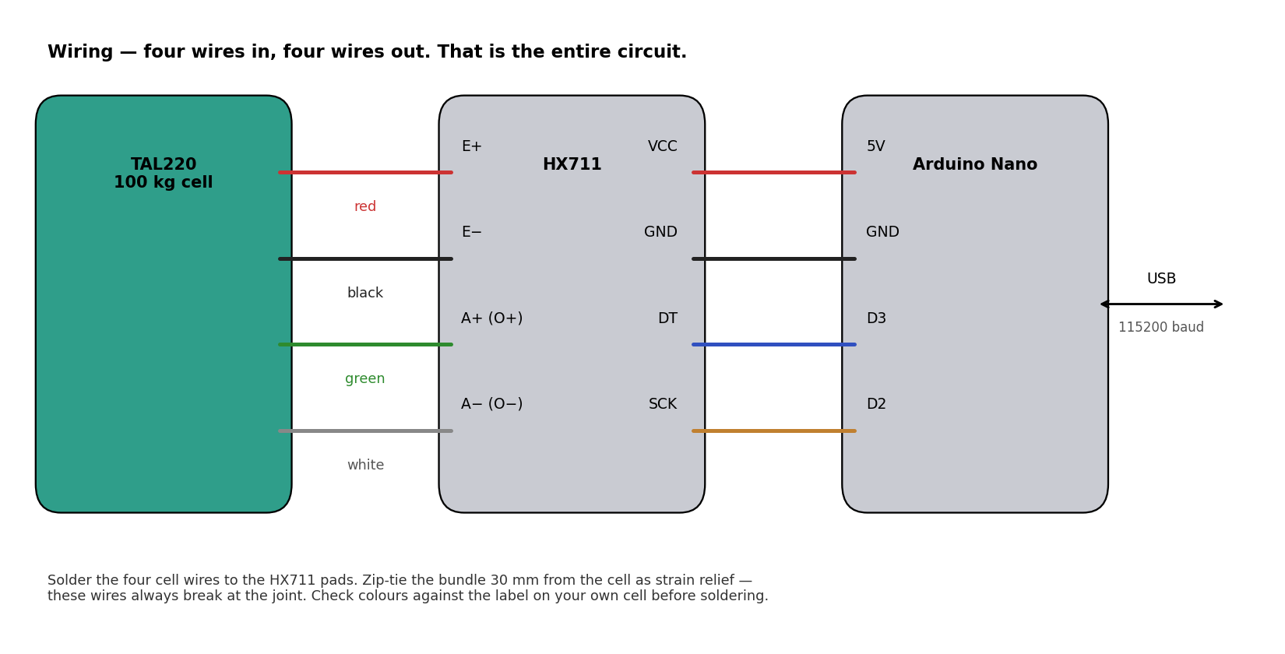
images/drawing_wiring.png
