nxtkim-1/hand-dynamometer/images/final_assembled_back.png

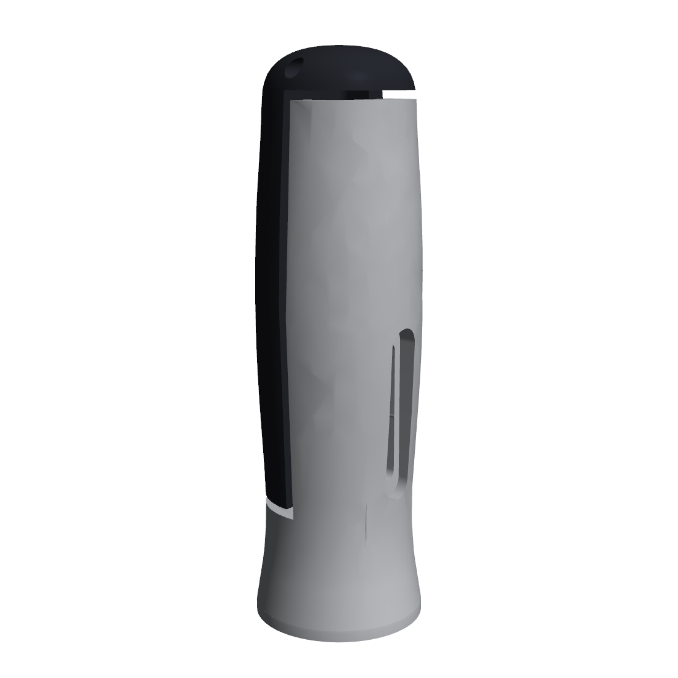
images/final_assembled_back.png
