nxtkim-1/hand-dynamometer/data/calibration_points_template_lb.csv

run | direction | step | plates | mass_lb | net_counts
1 | up | 0 | empty hanger | 0
1 | up | 1 | 5 | 5
1 | up | 2 | 10 | 10
1 | up | 3 | 10+5+2.5 | 17.5
1 | up | 4 | 25 | 25
1 | up | 5 | 35 | 35
1 | up | 6 | 45 | 45
1 | up | 7 | 50+5 | 55
1 | up | 8 | 50+10+5 | 65
1 | up | 9 | 45+25+2.5 | 72.5
1 | down | 8 | 50+10+5 | 65
1 | down | 7 | 50+5 | 55
1 | down | 6 | 45 | 45
1 | down | 5 | 35 | 35
1 | down | 4 | 25 | 25
1 | down | 3 | 10+5+2.5 | 17.5
1 | down | 2 | 10 | 10
1 | down | 1 | 5 | 5
1 | down | 0 | empty hanger | 0
2 | up | 0 | empty hanger | 0
2 | up | 1 | 5 | 5
2 | up | 2 | 10 | 10
2 | up | 3 | 10+5+2.5 | 17.5
2 | up | 4 | 25 | 25
2 | up | 5 | 35 | 35
2 | up | 6 | 45 | 45
2 | up | 7 | 50+5 | 55
2 | up | 8 | 50+10+5 | 65
2 | up | 9 | 45+25+2.5 | 72.5
2 | down | 8 | 50+10+5 | 65
2 | down | 7 | 50+5 | 55
2 | down | 6 | 45 | 45
2 | down | 5 | 35 | 35
2 | down | 4 | 25 | 25
2 | down | 3 | 10+5+2.5 | 17.5
2 | down | 2 | 10 | 10
2 | down | 1 | 5 | 5
2 | down | 0 | empty hanger | 0
3 | up | 0 | empty hanger | 0
3 | up | 1 | 5 | 5
3 | up | 2 | 10 | 10
3 | up | 3 | 10+5+2.5 | 17.5
3 | up | 4 | 25 | 25
3 | up | 5 | 35 | 35
3 | up | 6 | 45 | 45
3 | up | 7 | 50+5 | 55
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
