nxtkim-1/hand-dynamometer/data/example_calibration_points.csv

mass_kg | net_counts | direction | run
0 | -13 | up | 1
4.98 | 213892 | up | 1
10.02 | 430315 | up | 1
15.1 | 648481 | up | 1
20.05 | 861132 | up | 1
25.03 | 1075054 | up | 1
30.11 | 1293279 | up | 1
34.96 | 1501541 | up | 1
34.96 | 1501594 | down | 1
30.11 | 1293322 | down | 1
25.03 | 1075109 | down | 1
20.05 | 861235 | down | 1
15.1 | 648606 | down | 1
10.02 | 430382 | down | 1
4.98 | 213909 | down | 1
0 | 108 | down | 1
0 | -29 | up | 2
4.98 | 213846 | up | 2
10.02 | 430352 | up | 2
15.1 | 648544 | up | 2
20.05 | 861142 | up | 2
25.03 | 1075056 | up | 2
30.11 | 1293273 | up | 2
34.96 | 1501617 | up | 2
34.96 | 1501684 | down | 2
30.11 | 1293326 | down | 2
25.03 | 1075060 | down | 2
20.05 | 861228 | down | 2
15.1 | 648552 | down | 2
10.02 | 430399 | down | 2
4.98 | 213891 | down | 2
0 | 49 | down | 2
0 | -9 | up | 3
4.98 | 213970 | up | 3
10.02 | 430337 | up | 3
15.1 | 648555 | up | 3
20.05 | 861103 | up | 3
25.03 | 1075040 | up | 3
30.11 | 1293275 | up | 3
34.96 | 1501584 | up | 3
34.96 | 1501652 | down | 3
30.11 | 1293313 | down | 3
25.03 | 1075073 | down | 3
20.05 | 861215 | down | 3
15.1 | 648561 | down | 3
10.02 | 430450 | down | 3
4.98 | 213911 | down | 3
0 | 60 | down | 3
