nxtkim-1/hand-dynamometer/images/breadboard_test.png

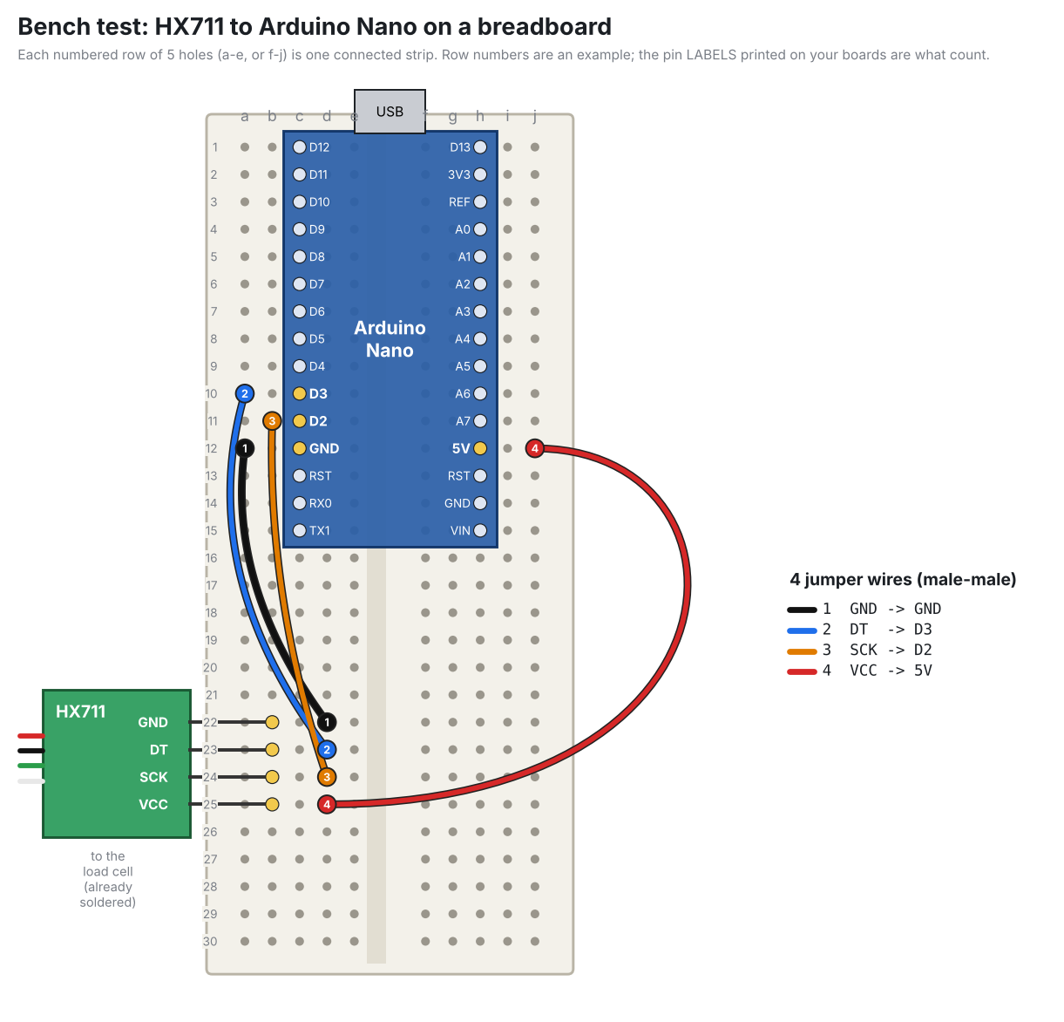
images/breadboard_test.png
