nxtkim-1/hand-dynamometer/webapp.py

"""
webapp.py - Browser version of the grip test (GripCheck).

Run on your computer:   python webapp.py      -> a browser tab opens at http://localhost:8000
Run as the public demo: GRIPCHECK_DEMO=1 gunicorn webapp:app ...   (see render.yaml)

The protocol, metrics, filtering, quality check, saving and report are the SAME code
as grip_test.py. Only the interaction changes: buttons, a countdown and a live graph
in the browser instead of typing in the terminal.

How the live graph works (Server-Sent Events):
  the browser opens /api/<session id>/step/<n>/stream and keeps the connection open;
  every new force sample is sent down that connection as one small message,
  and the page redraws the graph each time a message arrives.

Two ways to use the real dynamometer:
  python webapp.py --device      the server reads the Arduino over USB (port found automatically)
  Web Serial (Chrome / Edge)     the visitor's browser reads the Arduino and uploads each trial to
                                 /api/<session id>/step/<n>/upload, so the public site works with a
                                 real device too. Both paths use the same analysis code below.

Several visitors at once:
  each visitor gets a random session id when they press Continue, and every
  request carries it, so two people's tests are stored separately.
"""

import argparse
import json
import math
import os
import secrets
import threading
import time
import webbrowser
from datetime import datetime
from pathlib import Path

import matplotlib
matplotlib.use("Agg")   # draw figures to files only: a web server must never open plot windows (it can freeze on macOS)

from flask import Flask, Response, jsonify, request, send_from_directory

import fake_data
import filters
import grip_test
import metrics
import quality
from grip_compare import assess, plot_on_centiles
from report import fmt, make_report

WEB_DIR = Path(__file__).parent / "web"
HOST, PORT_NUMBER = "127.0.0.1", 8000          # 127.0.0.1 = only this computer can open the app
                                              # (not 5000: macOS AirPlay already uses that port)
PLAYBACK_DELAY = 1 / fake_data.SAMPLE_RATE_HZ   # play simulated curves at real speed (tests set 0)

# Public demo: simulated data only, short rests, no "newest report" page (it would show strangers' results)
DEMO = os.environ.get("GRIPCHECK_DEMO") == "1"
if DEMO:
    grip_test.USE_FAKE = True
    grip_test.REST_SECONDS = 3

MAX_UPLOAD_LINES = 20000           # one trial from the browser: 32 s at 80 Hz is about 2600 lines
MAX_SESSIONS = 100                 # forget the oldest unfinished tests beyond this (keeps memory small)
sessions = {}                      # session id -> that visitor's test
plot_lock = threading.Lock()       # matplotlib is not safe when two threads draw at the same time

app = Flask(__name__, static_folder=None)


# ---------- helpers -------------------------------------------------------

def build_plan(dominant):
    """Same order as the terminal app: alternate hands 3 times, then the fatigue test."""
    other = "left" if dominant == "right" else "right"
    plan = []
    for trial in range(1, grip_test.TRIALS_PER_HAND + 1):
        for hand in [dominant, other]:
            plan.append({"hand": hand, "trial": trial, "test": "max",
                         "seconds": grip_test.TRIAL_SECONDS})
    plan.append({"hand": dominant, "trial": 1, "test": "fatigue",
                 "seconds": grip_test.FATIGUE_SECONDS})
    return plan


def read_number(data, key, low, high, required):
    """Return a number from the form, None if optional and empty, or raise ValueError."""
    value = data.get(key)
    if value in (None, ""):
        if required:
            raise ValueError(f"Please enter {key.replace('_', ' ')}.")
        return None
    try:
        number = float(value)
    except (TypeError, ValueError):
        raise ValueError(f"{key.replace('_', ' ').capitalize()} must be a number.")
    if not low <= number <= high:
        raise ValueError(f"{key.replace('_', ' ').capitalize()} must be between {low} and {high}.")
    return number


def read_user(data):
    """Check every form field. The same limits as the terminal app, plus optional extras."""
    age = read_number(data, "age", 5, 100, required=True)
    if age != int(age):
        raise ValueError("Age must be a whole number.")
    sex = str(data.get("sex", "")).lower()
    dominant = str(data.get("dominant", "")).lower()
    if sex not in ("male", "female"):
        raise ValueError("Please choose male or female (the normative data are reported by sex).")
    if dominant not in ("right", "left"):
        raise ValueError("Please choose the dominant hand.")
    return {
        "age": int(age), "sex": sex, "dominant": dominant,
        "participant_id": str(data.get("participant_id", "")).strip()[:40],
        "height_cm": read_number(data, "height_cm", 100, 230, required=False),
        "weight_kg": read_number(data, "weight_kg", 20, 250, required=False),
        "injury": bool(data.get("injury")),
    }


def live_lines(ser, hand, test, seconds):
    """Yield text lines in real time, from the simulator or from the Arduino."""
    if ser is None:
        for line in fake_data.make_lines(hand, test, seconds):
            time.sleep(PLAYBACK_DELAY)
            yield line
    else:
        ser.reset_input_buffer()
        start = time.time()
        while time.time() - start < seconds:
            yield ser.readline().decode(errors="ignore").strip()


def sse(event, data):
    """Format one Server-Sent Event message."""
    return f"event: {event}\ndata: {json.dumps(data)}\n\n"


def close_serial(state):
    if state.get("ser") is not None:
        state["ser"].close()
        state["ser"] = None


def get_session(sid):
    """The visitor's test, or None if the id is unknown (expired, or never started)."""
    return sessions.get(sid)


def no_session():
    return jsonify({"error": "This test has expired. Please start again."}), 404


def analyse(state, index, readings, skipped):
    """Check, filter and score one recorded trial. Returns ("done", results) or ("failed", message).
    Shared by the live stream (server reads the device or the simulator) and browser uploads."""
    step = state["plan"][index]
    if not readings:
        hint = f" First non-data line: {skipped[0]!r}" if skipped else ""
        return "failed", {"message": "No data received - check the USB cable." + hint}

    notes = []
    rate = filters.estimate_rate_hz(readings)
    if rate < grip_test.MIN_RATE_HZ:
        notes.append(f"Data arrived at about {rate:.0f} samples/s; RFD needs at least "
                     f"{grip_test.MIN_RATE_HZ} and is reported as n/a.")
    try:
        grip_test.check_recording(readings, warned=True)   # calibration check (rate shown above)
    except RuntimeError as e:
        return "failed", {"message": str(e)}

    smooth = filters.filter_readings(readings)
    m = metrics.trial_metrics(smooth)
    result = {"hand": step["hand"], "trial": step["trial"], "test": step["test"],
              "readings": readings, "smooth": smooth, "metrics": m}
    if step["test"] == "max":
        result["quality"] = quality.check_trial(smooth)["label"]
    else:
        m["fatigue_index_pct"] = metrics.fatigue_index_pct(smooth)
    state["results"][index] = result      # repeating a trial simply replaces it

    return "done", {
        "peak_kg": fmt(m["peak_kg"]),
        "time_to_peak_ms": m["time_to_peak_ms"],
        "rfd_n_per_s": fmt(m["rfd_n_per_s"], 0),
        "fatigue_index_pct": fmt(m.get("fatigue_index_pct")),
        "quality": result.get("quality"),
        "notes": notes,
    }


def lines_to_readings(lines):
    """Parse firmware or simulator lines into readings (time restarts at 0); also return skipped lines."""
    readings, skipped, first_ms = [], [], None
    for line in lines:
        parsed = grip_test.parse_line(line)
        if parsed is None or not all(math.isfinite(v) for v in parsed):
            if line:
                skipped.append(line)
            continue
        time_ms, force_kg = parsed
        if first_ms is None:
            first_ms = time_ms
        readings.append({"time_ms": time_ms - first_ms, "force_kg": force_kg})
    return readings, skipped


# ---------- pages ---------------------------------------------------------

@app.get("/")
def home():
    return send_from_directory(WEB_DIR, "index.html")


@app.get("/web/<path:name>")
def web_files(name):
    return send_from_directory(WEB_DIR, name)


@app.get("/report")
@app.get("/report/<path:name>")
def report_page(name=None):
    """Short addresses for reports: /report is the newest, /report/<id> a specific one.
    The report's pictures are requested as /report/session_....png and served from the same folder."""
    folder = grip_test.SESSIONS_DIR
    if name is None:
        if DEMO:
            return "Reports are private: use the link shown at the end of your own test.", 404
        reports = sorted(folder.glob("session_*_report.html"))
        if not reports:
            return "No reports yet - run a test first.", 404
        name = reports[-1].name
    elif not name.startswith("session_"):
        name = f"session_{name}_report.html"
    # send_from_directory refuses paths like ../../ so only the sessions folder is reachable
    return send_from_directory(folder, name)


# ---------- API -----------------------------------------------------------

@app.get("/api/config")
def config():
    return jsonify({
        "use_fake": grip_test.USE_FAKE,
        "demo": DEMO,
        "browser_device": True,                    # the page may offer Web Serial (Chrome / Edge)
        "baud": grip_test.BAUD,
        "calibration": grip_test.CALIBRATION,
        "calibration_note": grip_test.CALIBRATION_NOTE,
        "rest_seconds": grip_test.REST_SECONDS,
        "prompt_posture": grip_test.PROMPT_POSTURE,
        "prompt_go": grip_test.PROMPT_GO,
        "prompt_fatigue": grip_test.PROMPT_FATIGUE,
    })


@app.post("/api/start")
def start():
    try:
        user = read_user(request.get_json(force=True) or {})
    except ValueError as e:
        return jsonify({"error": str(e)}), 400

    body = request.get_json(force=True) or {}
    browser = body.get("source") == "browser"      # the visitor's browser reads the device (Web Serial)
    ser = None
    if not grip_test.USE_FAKE and not browser:
        # one device: a new test on this computer replaces any earlier one
        for old in sessions.values():
            close_serial(old)
        sessions.clear()
        try:
            ser = grip_test.connect_serial()
        except RuntimeError as e:
            return jsonify({"error": str(e)}), 400

    while len(sessions) >= MAX_SESSIONS:
        sessions.pop(next(iter(sessions)))           # dicts keep insertion order: drop the oldest

    sid = secrets.token_hex(8)                       # 16 random characters, impossible to guess
    stamp = datetime.now().strftime("%Y-%m-%d_%H-%M-%S")
    if DEMO:
        stamp += "_" + sid[:8]                       # unique file names and private report links
    fake = grip_test.USE_FAKE and not browser
    rest = grip_test.REST_SECONDS if fake or not browser else 60      # real squeezes need real rests
    sessions[sid] = {"stamp": stamp, "user": user, "plan": build_plan(user["dominant"]),
                     "results": {}, "ser": ser, "browser": browser, "fake": fake}
    return jsonify({"session_id": sid, "plan": sessions[sid]["plan"],
                    "needs_tare": ser is not None or browser, "source": "browser" if browser else "server",
                    "rest_seconds": rest, "calibration_note": grip_test.calibration_note(fake)})


@app.post("/api/<sid>/tare")
def do_tare(sid):
    state = get_session(sid)
    if state is None:
        return no_session()
    if state.get("ser") is None:
        return jsonify({"error": "No device connected."}), 400
    grip_test.tare(state["ser"])
    return jsonify({"ok": True})


@app.get("/api/<sid>/step/<int:index>/stream")
def stream_step(sid, index):
    state = get_session(sid)
    if state is None:
        return no_session()
    if not 0 <= index < len(state["plan"]):
        return jsonify({"error": "No such trial."}), 400
    if state.get("browser"):
        return jsonify({"error": "This test records in the browser; it uploads each trial instead."}), 400
    step = state["plan"][index]

    def events():
        readings, skipped, first_ms = [], [], None
        for line in live_lines(state["ser"], step["hand"], step["test"], step["seconds"]):
            parsed = grip_test.parse_line(line)
            if parsed is None:
                if line:
                    skipped.append(line)
                continue
            time_ms, force_kg = parsed
            if first_ms is None:
                first_ms = time_ms
            point = {"time_ms": time_ms - first_ms, "force_kg": force_kg}
            readings.append(point)
            yield sse("point", {"t": point["time_ms"], "f": round(force_kg, 2)})

        yield sse(*analyse(state, index, readings, skipped))

    return Response(events(), mimetype="text/event-stream",
                    headers={"Cache-Control": "no-cache", "X-Accel-Buffering": "no"})


@app.post("/api/<sid>/step/<int:index>/upload")
def upload_step(sid, index):
    """One trial recorded by the visitor's browser from the real device (Web Serial)."""
    state = get_session(sid)
    if state is None:
        return no_session()
    if not state.get("browser"):
        return jsonify({"error": "This test was not started with a browser-connected device."}), 400
    if not 0 <= index < len(state["plan"]):
        return jsonify({"error": "No such trial."}), 400
    lines = (request.get_json(force=True, silent=True) or {}).get("lines")
    if (not isinstance(lines, list) or len(lines) > MAX_UPLOAD_LINES
            or not all(isinstance(x, str) and len(x) <= 120 for x in lines)):
        return jsonify({"error": "The recording could not be read."}), 400
    readings, skipped = lines_to_readings(lines)
    event, payload = analyse(state, index, readings, skipped)
    if event == "failed":
        return jsonify({"error": payload["message"]}), 400
    return jsonify(payload)


@app.post("/api/<sid>/finish")
def finish(sid):
    state = get_session(sid)
    if state is None:
        return no_session()
    plan = state["plan"]
    if len(state["results"]) != len(plan):
        return jsonify({"error": "Not every trial has been recorded yet."}), 400
    close_serial(state)

    results = [state["results"][i] for i in range(len(plan))]
    trials, fatigue = results[:-1], results[-1]
    stamp, user = state["stamp"], state["user"]
    folder = grip_test.SESSIONS_DIR

    summary = grip_test.summarize(trials, fatigue)
    grip_test.save_session(stamp, trials, fatigue, summary)     # save first, as in the terminal app
    result = assess(summary["overall_peak_kg"], user["age"], user["sex"])
    with plot_lock:
        plot_on_centiles(result, save_path=folder / f"session_{stamp}_centiles.png", show=False)
        make_report(stamp, user, trials, folder, state["fake"],
                    fatigue=fatigue, summary=summary, result=result,
                    open_browser=False, home_url="/", calibration=grip_test.calibration_note(state["fake"]))
    sessions.pop(sid, None)                                      # finished: free the memory
    return jsonify({"report_url": f"/report/{stamp}"})


if __name__ == "__main__":
    args = grip_test.device_args(argparse.ArgumentParser(description="GripCheck in the browser")).parse_args()
    if args.device:
        grip_test.use_device(args.port)
    url = f"http://localhost:{PORT_NUMBER}"
    print(f"GripCheck is running at {url}  (press Ctrl+C here to stop)")
    threading.Timer(1.0, lambda: webbrowser.open(url)).start()
    app.run(host=HOST, port=PORT_NUMBER, threaded=True)
