nxtkim-1/hand-dynamometer/grip_test.py

import argparse
import csv
import os
import time
from datetime import datetime
from pathlib import Path

import matplotlib.pyplot as plt

import fake_data
import filters
import metrics
import quality
from grip_compare import assess, print_report, plot_on_centiles
from report import fmt, make_report


USE_FAKE = True
# "auto" finds the Arduino by its USB chip, so nobody has to edit this file.
# To force a port: python webapp.py --device --port COM7   (or set GRIPCHECK_PORT)
PORT = os.environ.get("GRIPCHECK_PORT", "auto") #PORT는 컴퓨터가 Arduino와 통신하는 연결 경로야
BAUD = 115200 #match with arduino code

TRIALS_PER_HAND = 3
TRIAL_SECONDS = 5 #5초 동안 짜고 3번 함
FATIGUE_SECONDS = 32
REST_SECONDS = 3 if USE_FAKE else 60 #가짜 데이터는 60초동안 쉴 필요가 없어서 3초동안만 쉼

SESSIONS_DIR = Path(__file__).parent / "sessions" #파일을 만드는 경로만 만들어 놈

# Sanity limits for real hardware
MAX_PLAUSIBLE_KG = 150   # the load cell is rated 100 kg; anything far above means "not calibrated yet"
MIN_RATE_HZ = 40         # below this, RFD is unreliable (the firmware's default HX711 rate is 10 Hz)

# How the firmware's COUNTS_PER_KG was obtained:
#   "estimated" = from the load-cell datasheet (current state, about +/-10 %)
#   "measured"  = fitted from known masses (docs/04_calibration.md). Change this after calibrating.
CALIBRATION = os.environ.get("GRIPCHECK_CALIBRATION", "estimated")
CALIBRATION_NOTE = ("Forces are estimated from the load-cell datasheet (about \u00b110%), not from a measured "
                    "calibration, so peak values and percentiles are approximate.")

# USB chips used by Arduino Nano boards and clones (vendor IDs)
USB_SERIAL_CHIPS = {0x2341: "Arduino", 0x2A03: "Arduino", 0x1A86: "CH340", 0x0403: "FTDI", 0x10C4: "CP210x"}

PROMPT_POSTURE = "Sit upright, elbow at 90 degrees, forearm neutral, wrist straight."
PROMPT_GO = "Show Off Your Strength! Squeeze as hard as you can!"
PROMPT_FATIGUE = "Squeeze as hard as you can and KEEP squeezing for 30 seconds!"

def ask_user_info():
    while True:
        answer = input("Enter age (5-100): ").strip()
        if answer.isdigit() and 5 <= int(answer) <= 100:   # the normative table covers ages 5-100
            age = int(answer)
            break
        print("Please type a whole number between 5 and 100.")
    sex = input("Enter sex (male/female): ").strip().lower() #strip = erase space, lower = make it lower case
    while sex not in ("male", "female"):
        sex = input("Please type male or female: ").strip().lower()
    dominant = input("Dominant hand (right/left): ").strip().lower()
    while dominant not in ("right", "left"):
        dominant = input("Please type right or left: ").strip().lower()
    return age, sex, dominant

def calibration_note(is_fake):
    """Text for reports and the web page when real forces come from an estimated scale factor."""
    return None if is_fake or CALIBRATION == "measured" else CALIBRATION_NOTE


def find_arduino_port():
    """Return the serial port of the one connected Arduino, found by its USB chip."""
    from serial.tools import list_ports
    ports = list(list_ports.comports())
    matches = [p.device for p in ports if p.vid in USB_SERIAL_CHIPS]
    if len(matches) == 1:
        return matches[0]
    seen = [p.device for p in ports]
    if not matches:
        raise RuntimeError("No Arduino found. Check the USB cable (it must be a data cable, not charge-only) "
                           f"and close the Arduino IDE's Serial Monitor. Ports seen: {seen}")
    raise RuntimeError(f"Several possible Arduinos: {matches}. Choose one, e.g. "
                       f"python webapp.py --device --port {matches[0]}")


def use_device(port=None):
    """Switch from simulated data to the real device (what --device does)."""
    global USE_FAKE, REST_SECONDS, PORT
    USE_FAKE = False
    REST_SECONDS = 60
    if port:
        PORT = port


def device_args(parser):
    """The two command-line options shared by grip_test.py and webapp.py."""
    parser.add_argument("--device", action="store_true", help="use the real dynamometer instead of simulated data")
    parser.add_argument("--port", help="serial port, e.g. COM7 or /dev/cu.usbserial-110 (default: find it automatically)")
    return parser


def connect_serial():
    """Open the USB connection to the Arduino (shared by the terminal app and the web app)."""
    import serial                       # arduino data
    port = find_arduino_port() if PORT in ("auto", "") else PORT
    try:
        ser = serial.Serial(port, BAUD, timeout=1) #이 줄이 실제로 Arduino와 연결하는 부분이야, Arduino에게 데이터를 기다릴 때 최대 1초까지만 기다려
    except serial.SerialException as e:
        from serial.tools import list_ports
        ports = [p.device for p in list_ports.comports()]
        raise RuntimeError(f"Could not open {port!r} ({e}). Ports found on this computer: {ports}. "
                           "Close the Arduino Serial Monitor, or choose the port with --port.")
    time.sleep(2.5)                     # the Arduino restarts when we connect, then tares itself
    return ser

def tare(ser):
    """Zero the scale. Nothing may touch the handle while this runs."""
    ser.write(b"T")                     # serial 통로를 통해 Arduino에게 데이터를 보내라 T = tare (set zero)
    time.sleep(2.5)                     # tare averages 20 samples: ~2 s at 10 Hz, ~0.25 s at 80 Hz
    ser.reset_input_buffer()

def open_serial():
    ser = connect_serial()
    input("Remove all force from the handle, then press Enter to zero it...")
    tare(ser)
    return ser

def parse_line(line):
    """Turn one line into (time_ms, force_kg), or None if the line is not data.

    Works for both formats:
      simulator: "t_ms,force_kg"
      firmware:  "t_ms,raw,net,force_kg"  -> first column = time, last column = force
    """
    parts = line.split(",")
    if len(parts) < 2:
        return None
    try:
        return int(parts[0]), float(parts[-1])
    except ValueError:
        return None

def countdown(seconds=3):
    for n in range(seconds, 0, -1): #0초의 간격으로 -1씩 줄어듬 0은 포함 안함
        print(f"  {n}...") #3... 2.... 1.... 
        plt.pause(1) #1초 동안 기다리게 만듬

def rest(seconds):
    if seconds > 0:
        print(f"Rest for {seconds} seconds...")
        plt.pause(seconds) #그만큼 기다리게 함

def record(ser, ax, hand, title, test, seconds):
    """Record one squeeze and draw it live. Returns the raw curve."""
    if ser is None:
        fake_lines = fake_data.make_lines(hand, test, seconds) #fake data안에 make_lines variable 가짜 측정값
    else:
        ser.reset_input_buffer() #쌓여 있던 옛날 데이터를 전부 지워

    readings = []
    skipped = []   # lines that were not data, e.g. "# tared" or the firmware's header
    first_ms = None #첫번째 시간 저장 --> 아직은 0
    start = time.time() #몇초 지났는지 알려줌
    i = 0
    while True:
        if ser is None: #한줄 한줄 읽고 더 읽을게 없으면 반복을 끝냄
            if i>= len(fake_lines): #i 숫자가 fake_lines 갯수보다 높으면 
                break
            line = fake_lines[i] #i번째 코드를 읽음
        else:
            if time.time() - start >= seconds: #시작하고 지난 시간
                break #멈춘다
            line = ser.readline().decode(errors = "ignore").strip()
            """
            ser.readline(): 아두이노가 보낸 한 줄 --> 컴퓨터용 바이트 형태
            .decode(errors="ignore"): 그걸 글자로 바꿔요. 바꿀 수 없는 깨진 부분은 무시해요
            .strip(): 줄 앞뒤의 빈칸과 줄바꿈 기호를 지워요.
            """
        i += 1 #다음줄을 읽기 위함

        parsed = parse_line(line)
        if parsed is None: #데이터가 아닌 줄은 버리고 맨 위로 돌아가
            if line:
                skipped.append(line)
            continue
        time_ms, force_kg = parsed

        if first_ms is None: #아직 없으면
            first_ms = time_ms
        readings.append({"time_ms": time_ms - first_ms, "force_kg": force_kg}) #리스트 뒤에 추가함

        if len(readings) % 5 == 0: #나눈 나머지
            now_s = readings[-1]["time_ms"]/1000 #readings[-1] is last value on the list --> change ms --> s and save it
            ax.clear() 
            ax.plot([r["time_ms"]/ 1000 for r in readings], [r["force_kg"] for r in readings]) #r[] means in reading
            ax.set_xlim(max(0, now_s - 5), max(5, now_s)) #set_xlim(왼쪽 끝, 오른쪽 끝)은 가로축에서 보여줄 범위, max picks higher value
            ax.set_xlabel("Time (s)")
            ax.set_ylabel("Force (kg)")
            ax.set_title(title)
            plt.pause(0.1 if ser is None else 0.001)

    if len(readings) == 0:
        hint = f" First non-data line received: {skipped[0]!r}" if skipped else ""
        raise RuntimeError("No data received - check the USB cable and the PORT setting." + hint) #raise makes error on purpose
    return readings


def check_recording(readings, warned):
    """Catch the two silent hardware problems: wrong sample rate and missing calibration."""
    rate = filters.estimate_rate_hz(readings)
    if rate < MIN_RATE_HZ and not warned:
        print(f"  Warning: data arrive at about {rate:.0f} samples/s. RFD needs at least {MIN_RATE_HZ}; "
              "it will be reported as n/a. Set the HX711 to 80 Hz (RATE pin).")
        warned = True
    peak = max(r["force_kg"] for r in readings)
    if peak > MAX_PLAUSIBLE_KG:
        raise RuntimeError(f"Peak of {peak:.0f} 'kg' is not physically possible - the firmware is probably "
                           "not calibrated yet. Run software/calibrate.py and set COUNTS_PER_KG.")
    return warned


def run_protocol(ser, stamp, user):
    dominant = user["dominant"]
    other = "left" if dominant == "right" else "right"
    trials = []
    warned = False

    plt.ion()
    fig,ax = plt.subplots()

    for trial in range(1, TRIALS_PER_HAND + 1):
        for hand in [dominant, other]:
            print(f"\n--- {hand.upper()} hand, trial {trial} of {TRIALS_PER_HAND} ---")
            print(PROMPT_POSTURE)
            input("Press Enter when ready...")
            countdown()
            print(PROMPT_GO)
            readings = record(ser, ax, hand, f"{hand} hand - {trial}", "max", TRIAL_SECONDS)
            warned = check_recording(readings, warned)
            smooth = filters.filter_readings(readings)
            m = metrics.trial_metrics(smooth)
            q = quality.check_trial(smooth)
            print(f"Relax. Peak: {m['peak_kg']:.1f} kg")
            if q["label"] != "good":
                print(f"  Warning: possible {q['label']} - consider repeating this trial.")
            trials.append({"hand": hand, "trial": trial, "test": "max",
                           "readings": readings, "smooth": smooth,
                           "metrics": m, "quality": q["label"]})
            make_report(stamp, user, trials, SESSIONS_DIR, USE_FAKE, calibration=calibration_note(USE_FAKE))
            rest(REST_SECONDS)

    print(f"\n--- FATIGUE TEST ({dominant.upper()} hand) ---")
    print(PROMPT_POSTURE)
    input("Press Enter when ready...")
    countdown()
    print(PROMPT_FATIGUE)
    readings = record(ser, ax, dominant, "30-second fatigue test",
                      "fatigue", FATIGUE_SECONDS)
    check_recording(readings, warned)
    smooth = filters.filter_readings(readings)
    fatigue = {"hand": dominant, "trial": 1, "test": "fatigue",
               "readings": readings, "smooth": smooth, "metrics": metrics.trial_metrics(smooth)}
    fatigue["metrics"]["fatigue_index_pct"] = metrics.fatigue_index_pct(smooth)
    make_report(stamp, user, trials, SESSIONS_DIR, USE_FAKE, fatigue=fatigue,
                calibration=calibration_note(USE_FAKE))
    print("Relax. Fatigue test done.")    

    plt.ioff()
    plt.close(fig)
    return trials, fatigue

def best_trial(trials, hand):
    best = None
    for t in trials: 
        if t["hand"] == hand:
            if best is None or t["metrics"]["peak_kg"] > best["metrics"]["peak_kg"]:
                best = t
    return best

def summarize(trials, fatigue):
    best_right = best_trial(trials, "right")
    best_left = best_trial(trials, "left")
    ratio, weaker_pct = metrics.asymmetry(best_left["metrics"]["peak_kg"], best_right["metrics"]["peak_kg"])

    return {
        "right": best_right["metrics"],
        "left": best_left["metrics"],
        "ratio": ratio,
        "weaker_pct": weaker_pct,
        "fatigue_index_pct": fatigue["metrics"]["fatigue_index_pct"],
        "overall_peak_kg": max(best_right["metrics"]["peak_kg"],
                               best_left["metrics"]["peak_kg"]),
    }
               
def print_summary(summary):
    print("\n" + "=" * 50)
    print("GRIP TEST SUMMARY (best of 3 trials per hand)")
    print("-" * 50)  
    for hand in ["right", "left"]:
        m = summary[hand]
        print(f"{hand.capitalize():5} peak {fmt(m['peak_kg']):>5} kg | "
              f"time to peak {m['time_to_peak_ms']:4d} ms | "
              f"RFD {fmt(m['rfd_n_per_s'], 0):>6} N/s")
    print(f"Fatigue index: {fmt(summary['fatigue_index_pct'])}% decline over 30 s")
    print(f"Left/right ratio: {fmt(summary['ratio'], 2)} "
        f"(weaker hand {fmt(summary['weaker_pct'])}% weaker)")
    print("=" * 50)

def round_or_blank(x, digits):
    """round() that writes an empty cell instead of crashing when a metric could not be computed."""
    return "" if x is None else round(x, digits)

def save_session (stamp, trials, fatigue, summary):
    SESSIONS_DIR.mkdir(exist_ok = True)

    raw_path = SESSIONS_DIR / f"session_{stamp}_raw.csv"
    with open(raw_path, "w", newline="") as f:
        writer = csv.writer(f)
        writer.writerow(["hand", "trial", "test", "time_ms", "force_kg"])
        for t in trials + [fatigue]:
            for r in t["readings"]:
                writer.writerow([t["hand"], t["trial"], t["test"], r["time_ms"], r["force_kg"]])

    summary_path = SESSIONS_DIR / f"session_{stamp}_summary.csv"
    with open(summary_path, "w", newline="") as f:
        writer = csv.writer(f)
        writer.writerow(["hand", "trial", "test", "peak_kg",
                         "time_to_peak_ms", "rfd_n_per_s", "fatigue_index_pct", "quality"])

        for t in trials + [fatigue]:
            m = t["metrics"]
            writer.writerow([t["hand"], t["trial"], t["test"], m["peak_kg"],
                             m["time_to_peak_ms"], round_or_blank(m["rfd_n_per_s"], 1),
                             m.get("fatigue_index_pct", ""), t.get("quality", "")])
        
        writer.writerow(["left_right_ratio", round_or_blank(summary["ratio"], 3)])
        writer.writerow(["weaker_hand_pct", round_or_blank(summary["weaker_pct"], 1)])

    print(f"Saved {raw_path.name} and {summary_path.name}")

def main():
    stamp = datetime.now().strftime("%Y-%m-%d_%H-%M-%S")
    age, sex, dominant = ask_user_info()
    user = {"age": age, "sex": sex, "dominant": dominant}
    ser = None if USE_FAKE else open_serial()

    trials, fatigue = run_protocol(ser, stamp, user)
    if ser is not None:
        ser.close()
        

    summary = summarize(trials, fatigue)
    save_session(stamp, trials, fatigue, summary)   # save first, so a later problem never loses the data
    print_summary(summary)

    result = assess(summary["overall_peak_kg"], age, sex)
    print_report(result)

    plot_on_centiles(result, save_path=SESSIONS_DIR / f"session_{stamp}_centiles.png", show=False)
    make_report(stamp, user, trials, SESSIONS_DIR, USE_FAKE,
                fatigue=fatigue, summary=summary, result=result,
                calibration=calibration_note(USE_FAKE))

if __name__ == "__main__":
    args = device_args(argparse.ArgumentParser(description="Grip strength test in the terminal")).parse_args()
    if args.device:
        use_device(args.port)
    main()
