nxtkim-1/hand-dynamometer/(commit log)

2026-09-25 Project start: requirements, load cell choice, firmware v1.0, Python logging and calibration
    Requirements written; first load cell (80 x 12.7 mm bar) rejected because that form factor stops near 50 kg, re-specified as the CZL601 100 kg parallel-beam cell. Firmware v1.0 (read HX711, tare, CSV at 115200 baud) and the Python logger, calibration and hold-analysis scripts written; software tested end to end with logger.py fake.
    Written down on 2026-10-17 from docs/06_build_log.md, this project's chat and the project folder.
    [example_calibration_points.csv]
2026-09-25 Add Dodds 2014 normative data and CSV loader
    [dodds2014_norms.csv]
2026-10-08 Design iterations up to the split grip, print files for the 30 mm cell, build docs
    Iterations, in order: frame, two plates, clinical head (A), symmetric head (S), plain split tube (P1), sculpted tube (P1b), split grip. Earlier versions kept in cad/archive/. Print-ready parts, assembly, calibration, verification, daily plan and interview docs. Design choices and rejections by Thomas. Exact dates for these iterations weren't recorded: they happened between Sep 25 and Oct 7, the day the build schedule and reminders were set.
    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
    [assembly.step, bom.csv, calibration_cradle.step, calibration_cradle.stl, calibration_cradle_print.stl, cover.step, cover.stl, cover_print.stl]
2026-10-12 Log caliper measurements: the real cell is 130 x 40 x 22 with 3 holes per end
    Measured by Thomas (cell in two passes, then the Nano). The cell is 10 mm wider than the spec the CAD used and has 3 holes per end, so the old fit coupon and halves would not have fitted.
    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
2026-10-12 Rebuild CAD for the real cell: 40 mm wide, 3 bolts per end, roomy round handle; fit coupon v2; soldering guide
    Thomas chose handle option B and 3 bolts per end. All checks pass (halves never touch, 3.00 mm bending-zone gap, every bolt passes freely). The 30 mm design moved to cad/archive/v1_30mm_cell/. dynamometer_cad.py is shown in its Oct 13 form: the electronics-pod draft was added the next day and the Oct 12-only version wasn't kept.
    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
    [assembly.step, calibration_cradle.step, calibration_cradle.stl, calibration_cradle_WIP_do_not_print.stl, calibration_cradle_print.stl, cover.step, cover.stl, cover_WIP_do_not_print.stl]
2026-10-13 Electronics pod draft (P1, 50 mm bay); rename fit coupon to v2 after a near-miss with the old file
    Thomas chose pod P1 and asked to keep the load cell cable uncut, which reopened the cable plan. The coupon on the slicer plate was the old one, so the new file got a distinct name. Printed the v2 coupon at the RPC.
    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
    [cover_print_after_G0.stl, finger_half_print_after_G0.stl, fit_coupon_v2_print.stl, palm_half_print_after_G0.stl]
2026-10-14 G0 passed on the real cell; dish base draft for the uncut cable (v1, then v2)
    G0 by Thomas: three M6 bolts thread in, no wobble, paper and feeler gauge slide freely, nothing cracked. Thomas needs at least 15 mm of space where the cable leaves the cell. V2 changed the silhouette after Thomas's feedback on how v1 looked.
    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
    [cable_path_model.stl, cable_path_model_v2.stl, calibration_cradle_print.stl, cover_print.stl, finger_dish_DRAFT.step, finger_dish_DRAFT_do_not_print.stl, finger_dish_v2_DRAFT.step, finger_dish_v2_DRAFT_do_not_print.stl]
2026-10-14 Compact box draft (v3): closed base with 18.5 mm cable bay and room for about 1 m of coiled cable
    Offered next to the dish. All checks pass, and each check was run against a deliberately broken version to show it catches problems. Added print settings for a better surface after Thomas found the coupon rough.
    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
    [base_test_v3_DRAFT.step, base_test_v3_DRAFT_do_not_print.stl, cable_path_v3.stl, coil_zone_v3.stl, cover_compact_v3_DRAFT.step, cover_compact_v3_DRAFT_do_not_print.stl, finger_compact_v3_DRAFT.step, finger_compact_v3_DRAFT_do_not_print.stl]
2026-10-15 Complete standardized 3-trial protocol with five metrics (Stage 3)
2026-10-16 Release v3 compact box for printing; archive superseded designs
    Thomas chose the compact box (A). Print files numbered in print order, base test first; the finger half prints upside down on its flat top with no supports. Hardware now 6 x M6 x 25 and 4 x M3 x 10. Assembly steps and BOM updated. The Nano's USB is micro-USB (Thomas).
    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
    [1_base_test_v3.stl, 2_palm_half_v3.stl, 3_finger_half_v3.stl, 4_cover_v3.stl, assembly.step, base_test_v3.step, base_test_v3_DRAFT.step, base_test_v3_DRAFT_do_not_print.stl]
2026-10-16 Add HX711 bench test sketch and breadboard layout for the G1 check
    Prints raw counts at 115200 baud, DT on D3 and SCK on D2 like the firmware (the library's example has them the other way round). Added when Thomas asked how to test the circuit on a breadboard.
    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
2026-10-17 Concept: Jamar-style two-handle dynamometer around the same load cell
    Asked for by Thomas after seeing a commercial digital grip meter. Concept only, not released: cell in a body beside the grip, palm bar with 5 positions, finger bar on the cell's free end. Checks pass. Commit time is approximate (that evening).
    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
    [cover_CONCEPT.step, finger_part_CONCEPT.step, frame_CONCEPT.step, palm_bar_CONCEPT.step]
2026-10-17 Firmware tutorial: four steps from hello-serial to v1.0, each with a check and an exercise
    Step 1 serial and millis(), step 2 reading the HX711, step 3 tare with a 'waiting for HX711' message, step 4 CSV output, kg and the t command (equals grip_firmware v1.0). All six sketches compile against stub headers. Written as teaching material; Thomas types each step into firmware/my_firmware/ and commits it on the day it works.
2026-10-24 Update 02_printing.md for the v3 print files
2026-10-24 README: note current v3 design and v4 concept page
2026-10-24 Add CAD proof screenshots
2026-10-24 Add CAD proof screenshots to README
2026-10-24 Track CAD verification notes
2026-10-24 Tighten README and track CAD notes
2026-10-25 Fix show parameter in plot_on_centiles and summary typo
    [grip_compare.py, grip_test.py]
2026-10-26 Simulate faulty trials: false start, slip and submaximal effort
    [fake_data.py]
2026-10-29 Compute metrics on Butterworth-filtered curves; keep raw data unchanged
2026-11-01 Add moving-average and Butterworth filters with Monte Carlo RFD comparison
2026-11-01 Skip old-format and badly named session files
    [history.py]
2026-11-02 new file and debug errors
    [grip_test.py, history.py, quality.py]
2026-11-04 changed coding and png error
    [fake_data.py, quality.py, train_quality.py]
2026-11-04 Make the app ready for the Arduino and add a pytest suite
    - Read both the simulator's 2-column and the firmware's 4-column serial
    format (first column = time, last = force); before this, every firmware
    line was silently skipped and the app stopped with "No data received".
    - Measure each recording's real sample rate, design the Butterworth filter
    for it, and report RFD as n/a when the window has fewer than 5 points
    (10 Hz data underestimated RFD by about 40%).
    - Stop with a clear message if forces are physically impossible
    (uncalibrated firmware) and list available ports if PORT is wrong.
    - Save the session before printing, and print/save missing metrics as
    n/a instead of crashing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
    [filters.py, grip_test.py, metrics.py]
2026-11-04 Add a browser version of the grip test with live graph and PDF report
    - webapp.py (Flask, local only): the same protocol, filtering, metrics,
    quality check, saving and report as grip_test.py, driven by buttons
    instead of terminal input. Force samples stream to the page with
    Server-Sent Events so the graph draws live.
    - web/: participant form (age, sex, dominant hand; optional ID, height,
    weight, injury history), posture instructions, 3-2-1 countdown, live
    canvas graph with earlier trials shown faintly, per-trial feedback with
    the option to repeat a flagged trial, timed rest, Enter-key support.
    - report.py: Download PDF button and print styles so the saved PDF has
    the same layou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
2026-11-04 Rename the web app to GripCheck, warm colour scheme, short addresses
    - Brand name GripCheck on the app, report heading and PDF file name
    (the page title is now "GripCheck report <ID> <date>").
    - Warm palette: burnt orange for brand and right hand (5.2:1 contrast
    with white text), violet for left hand, raspberry for the fatigue test,
    warm stone neutrals; report uses the same colours.
    - Shorter addresses: http://localhost:8000 (port 5000 clashes with macOS
    AirPlay), /report for the newest report, /report/<date_time> for one
    session instead of /sessions/session_..._report.html.
    [report.py, webapp.py]
2026-11-04 Prepare GripCheck for a public online demo
    - One test per visitor: each start returns a random session id that every
    later request carries, so simultaneous visitors no longer overwrite each
    other (previously one shared "state" held a single test).
    - Demo mode (GRIPCHECK_DEMO=1): simulated data only, short rests, a notice
    not to enter personal data, report links with a private random part,
    and no "/report" newest-report page that would show strangers' results.
    - Report drawing is serialised with a lock (matplotlib is not thread-safe).
    - quality.check_trial falls back to the rules if the saved model cannot be
    loaded (e.g. a different scikit-learn version on the server).
    - render.yaml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
    [quality.py, webapp.py]
2026-11-09 Restyle GripCheck: shared design tokens, accessible controls, matching report
    - web/tokens.css and web/base.css hold every colour, font size and spacing value; the app, the live graph and the report all read them.
    - Disabled buttons are solid grey with readable text; every control has hover, pressed and keyboard-focus states.
    - Live numbers are no longer read aloud 50 times a second; the graph gets a text summary after each trial.
    - Progress steps show a tick or ! as well as colour, and stay on one row on phones.
    - Report uses the same look as the app, with readable charts in the app's hand colours and a scrollable table on phones.
    - No change to the test protocol, the server or the calculat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
    [grip_compare.py, report.py]
2026-11-12 Build-day plan: Dupont jumpers HX711 to Nano, G1, assembly into the v3 box, G2
    Claude-Session: https://claude.ai/code/session_013gqdkuU9fMoCx8EyDtiRaw
2026-11-12 G2 done: assembled grip reads and returns (numbers to be added)
    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
2026-11-12 Provisional datasheet scale factor (42952 counts/kg), clearly marked as not calibrated
    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
2026-11-12 README: Tillaart firmware option; state that the scale factor is a datasheet estimate until calibration
    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
2026-11-13 Use the real device without editing code: Web Serial in the browser, --device with port auto-detect, estimated-calibration notice
    - Browser path: Connect device (Chrome/Edge) reads the Nano via Web Serial and uploads each trial
    to /api/<sid>/step/<n>/upload; the same analysis function serves the live stream and uploads,
    so the public demo can measure real squeezes.
    - python webapp.py --device / grip_test.py --device; port found by USB chip (CH340, FTDI, CP210x, Arduino).
    - CALIBRATION = estimated|measured: banner on the start page and in every real-device report.
    - Real-device tests get 60 s rests; uploads are size-checked and non-finite values ignored.
    - 16 new tests (50 total).
    Co-Aut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
2026-11-13 Claude Code handoff: CLAUDE.md, docs/HANDOFF.md, pound-based calibration template
    - CLAUDE.md: project map, commands, hardware facts, honesty and git rules (loads in every Claude Code session)
    - docs/HANDOFF.md: status of G0-G4 and PRs, ordered to-do list with exact steps
    - software/calibrate.py accepts mass_lb; data/calibration_points_template_lb.csv holds the plate plan
    - .gitignore: CLAUDE.local.md (personal instructions)
    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
    [calibration_points_template_lb.csv]
2026-11-13 Device check tool and Windows launchers; docs for the local route
    - software/check_device.py: finds the Nano, checks firmware output, calibration line, sample rate,
    zeroing, squeeze direction and plausibility, and return to zero; PASS/WARN/FAIL with fixes (6 tests)
    - check_device.bat / start_gripcheck.bat (+ tools/setup_python.bat): first run creates .venv and installs
    requirements, then runs the check or GripCheck --device
    - README, HANDOFF, CLAUDE.md updated
    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
    [check_device.py]
